vvip-68/GyverLampWiFi/Android/lamp.png

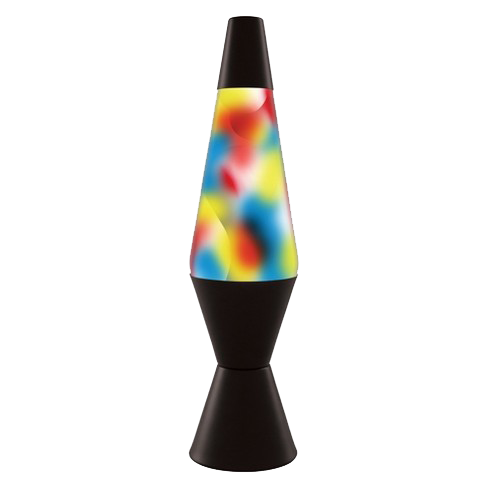
Android/lamp.png
