vvip-68/GyverLampWiFi/Android/menu_bg.png

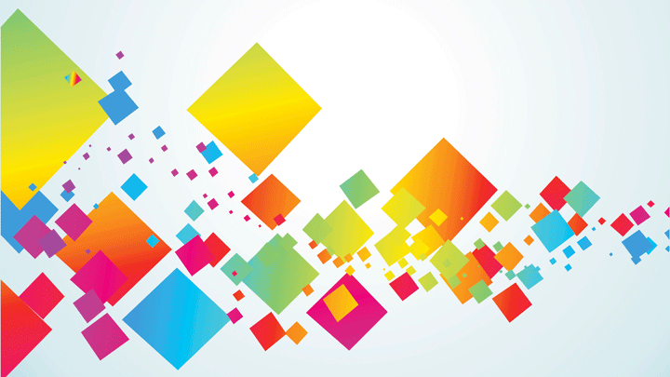
Android/menu_bg.png
