vvip-68/GyverLampWiFi/schemes/nodemcu.png

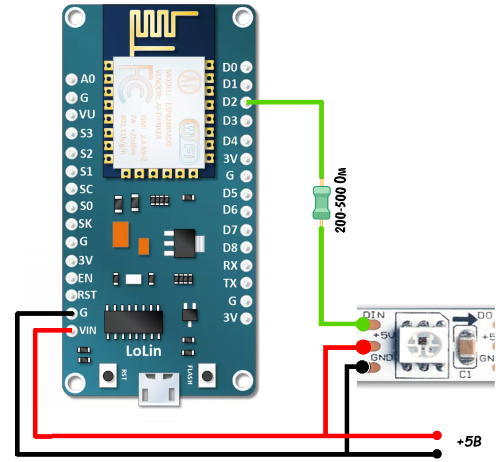
schemes/nodemcu.png
