vvip-68/GyverLampWiFi/schemes/scheme1,1.jpg

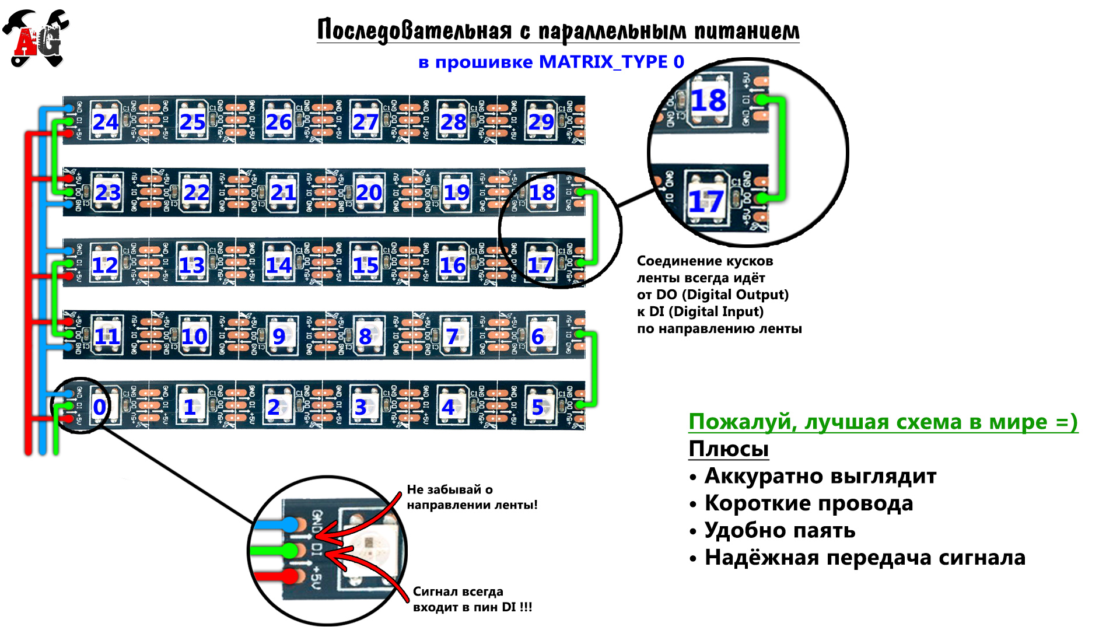
schemes/scheme1,1.jpg
