vvip-68/GyverLampWiFi/schemes/scheme2.jpg

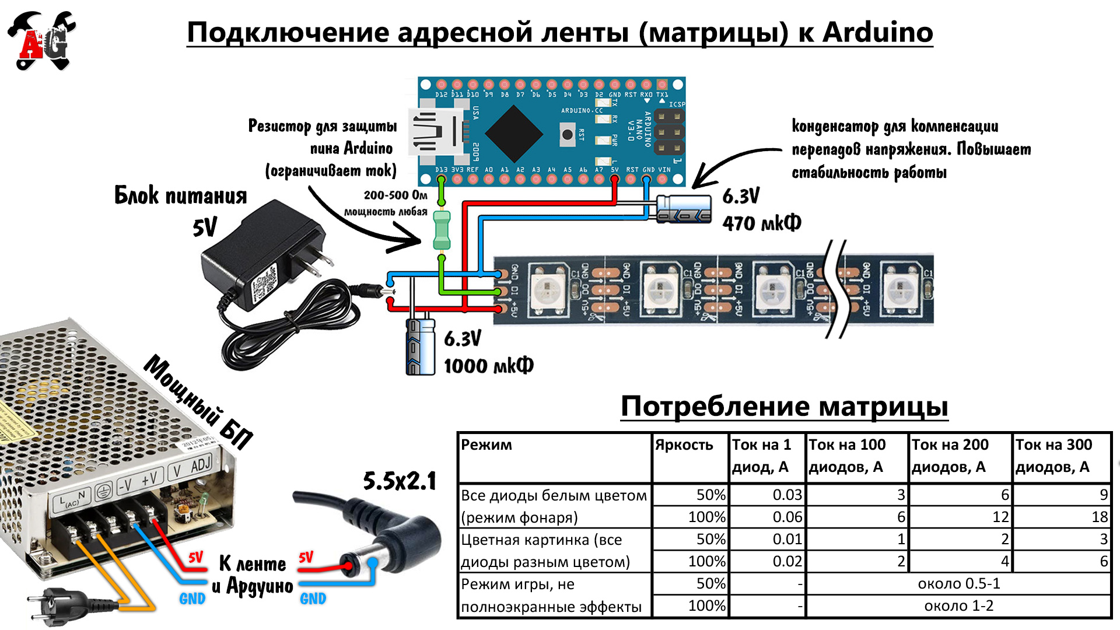
schemes/scheme2.jpg
