vvip-68/GyverLampWiFi/schemes/scheme3.jpg

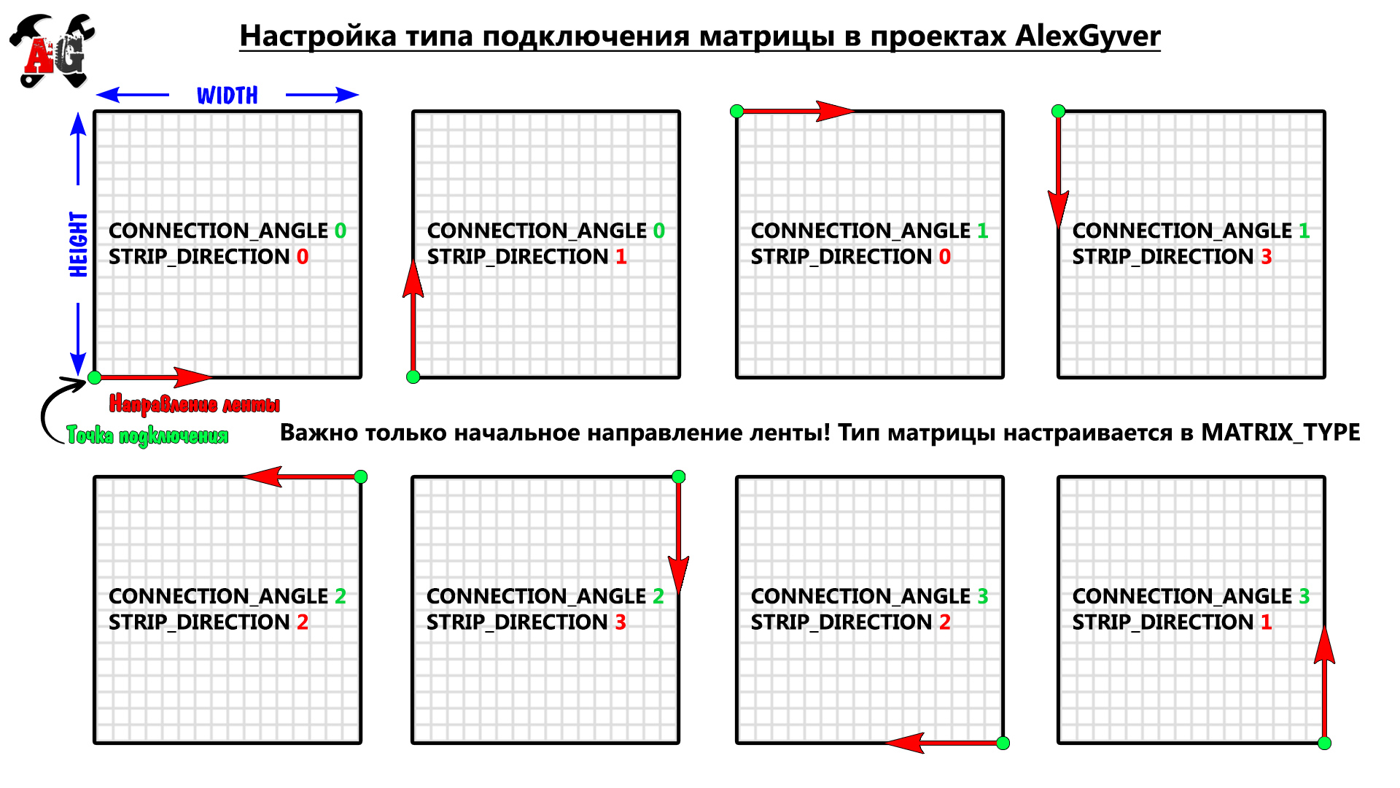
schemes/scheme3.jpg
