vvip-68/GyverLampWiFi/3D_print/STL/ring_for_paper.stl

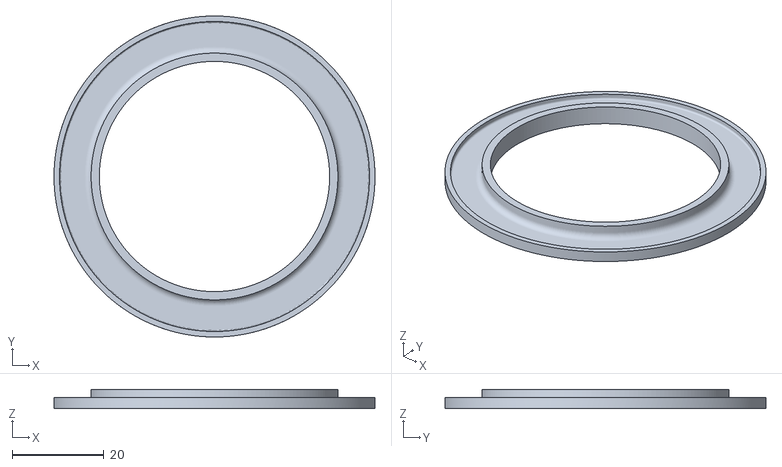
[picture p12: CAD file, 2019-07-05]
3D_print/STL/ring_for_paper.stl
70.0 x 70.0 x 4.20
