vvip-68/GyverLampWiFi/3D_print/STL/Lamp-Top.stl

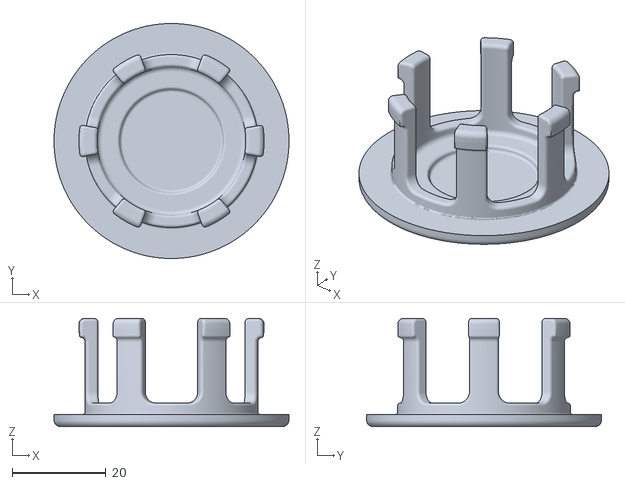
[picture p13: CAD file, 2019-07-05]
3D_print/STL/Lamp-Top.stl
50.0 x 50.0 x 23.0
