vvip-68/GyverLampWiFi/3D_print/STL/Ring_top.stl

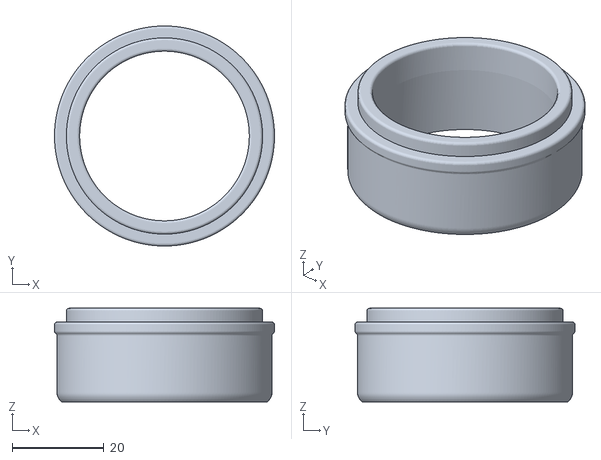
[picture p14: CAD file, 2019-07-05]
3D_print/STL/Ring_top.stl
48.0 x 48.0 x 20.4
