vvip-68/GyverLampWiFi/3D_print/STL/Lamp_Down.stl

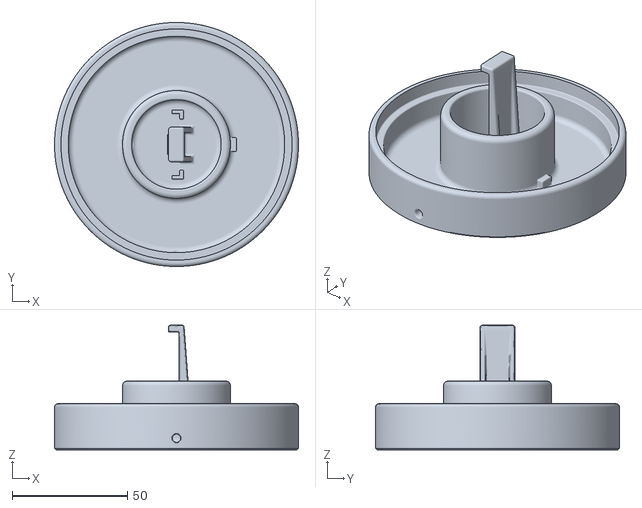
[picture p15: CAD file, 2019-07-05]
3D_print/STL/Lamp_Down.stl
105.8 x 105.8 x 54.0
