vvip-68/GyverLampWiFi/3D_print/STL/Lamp_Down_DC-output.stl

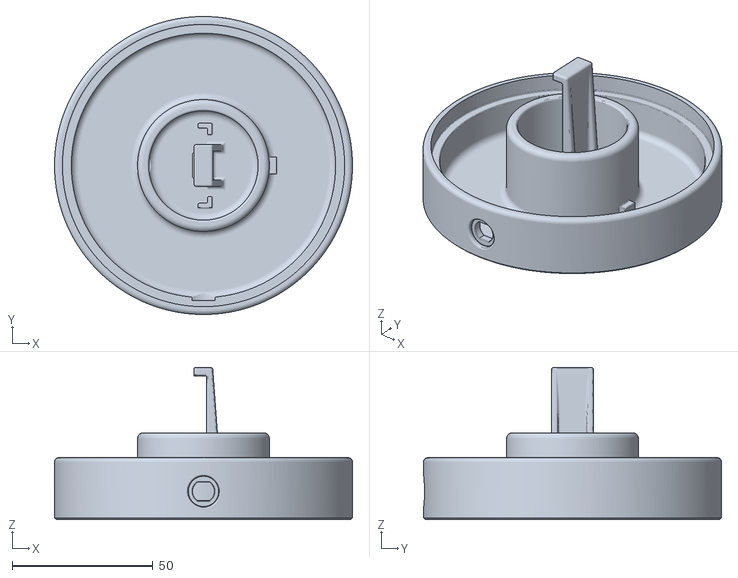
[picture p16: CAD file, 2019-07-05]
3D_print/STL/Lamp_Down_DC-output.stl
105.8 x 105.8 x 54.0
