vvip-68/GyverLampWiFi/3D_print/photo (1).jpg

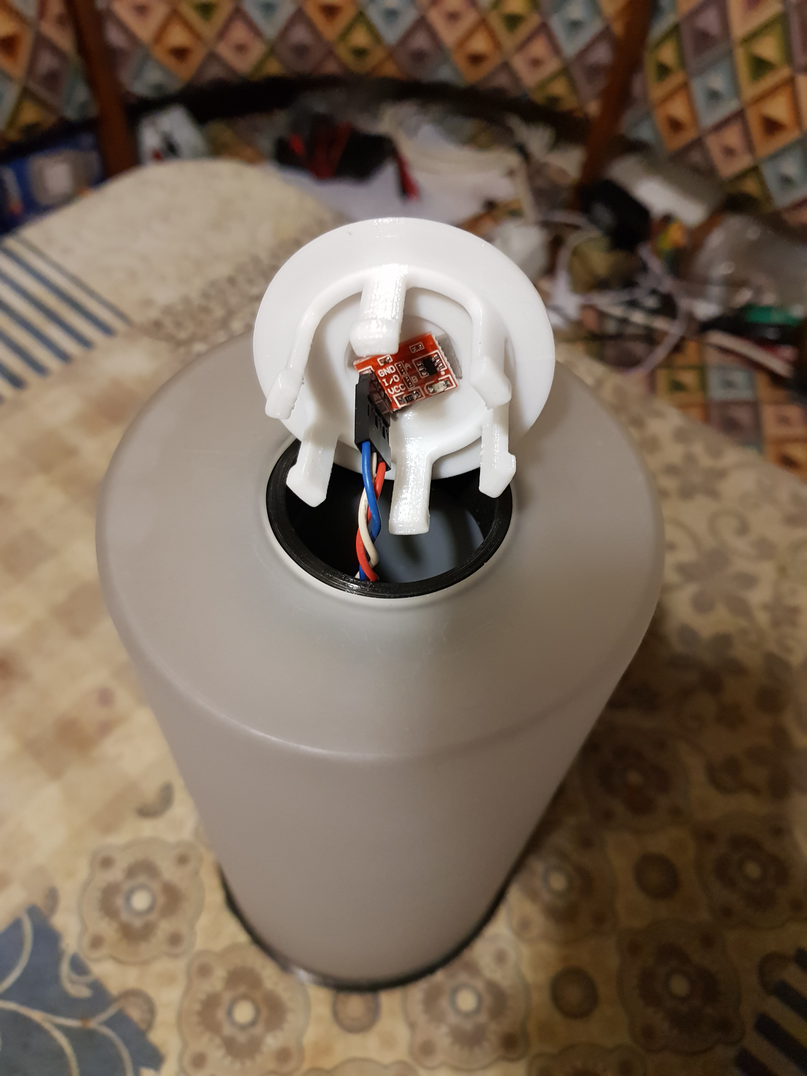
3D_print/photo (1).jpg
