vvip-68/GyverLampWiFi/3D_print/photo (2).jpg

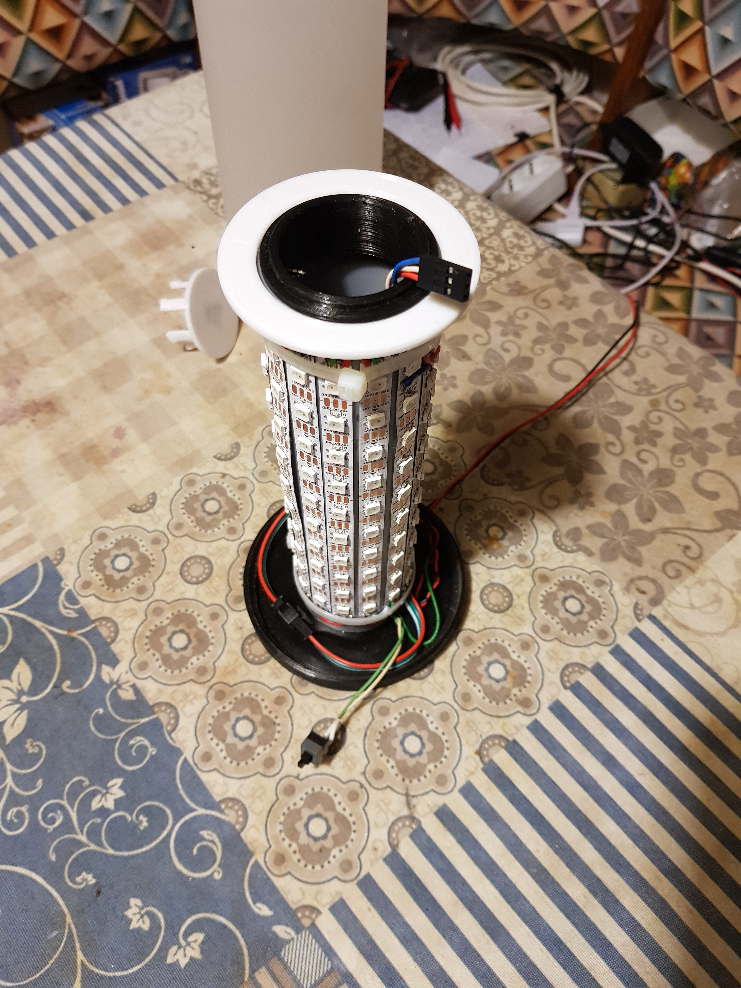
3D_print/photo (2).jpg
