vvip-68/GyverLampWiFi/3D_print/photo (3).jpg

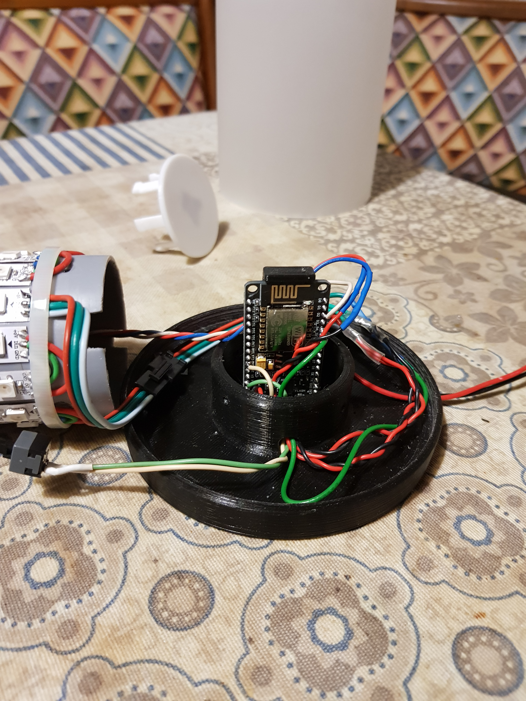
3D_print/photo (3).jpg
