vvip-68/GyverLampWiFi/3D_print/photo (4).jpg

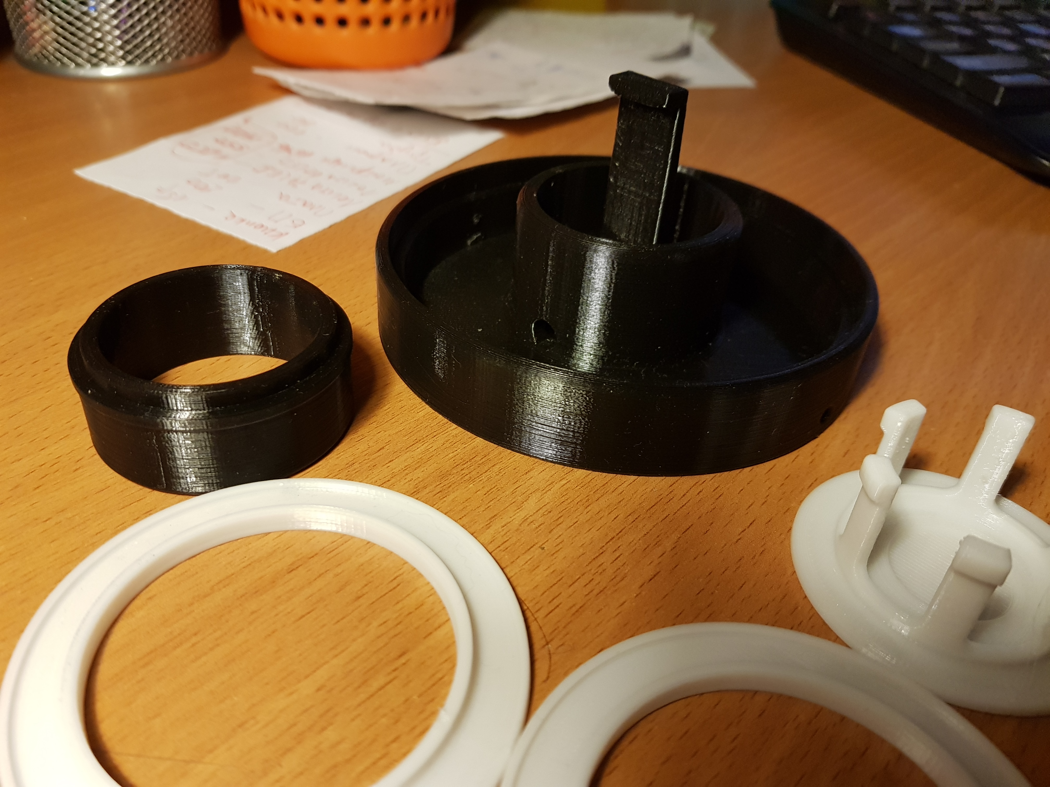
3D_print/photo (4).jpg
