vvip-68/GyverLampWiFi/3D_print/photo (5).jpg

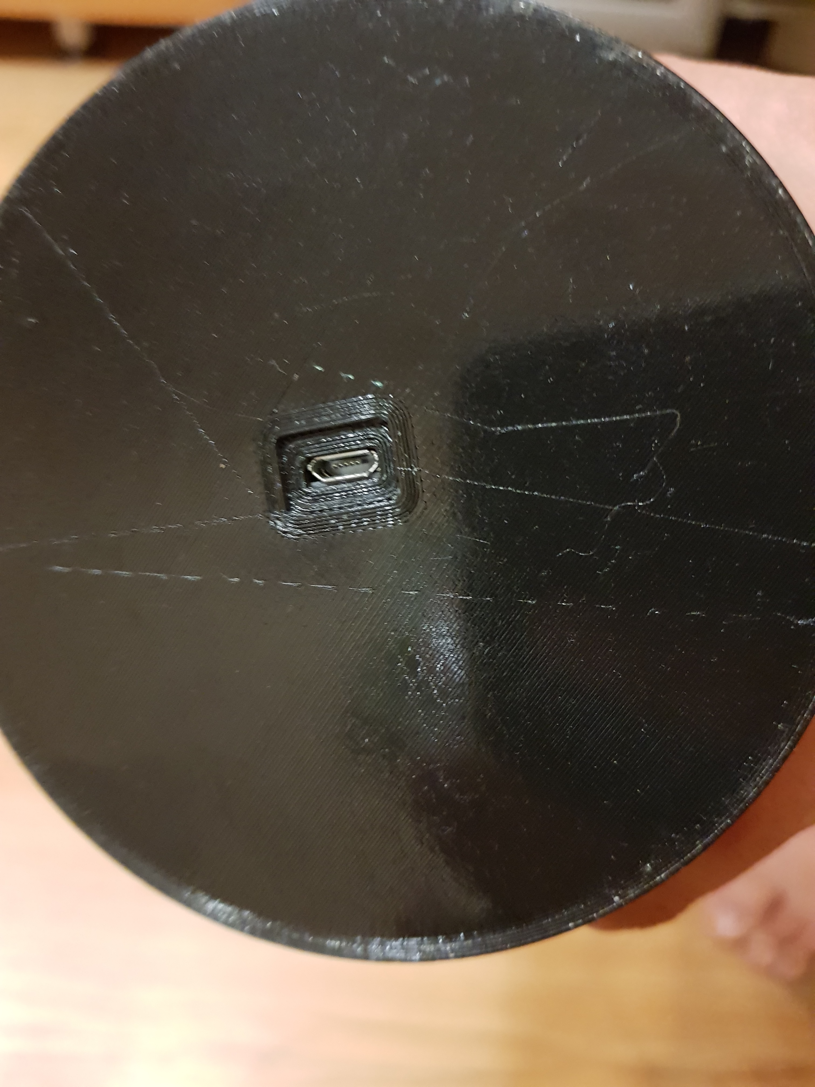
3D_print/photo (5).jpg
