vvip-68/GyverLampWiFi/wiki/Step_01.png

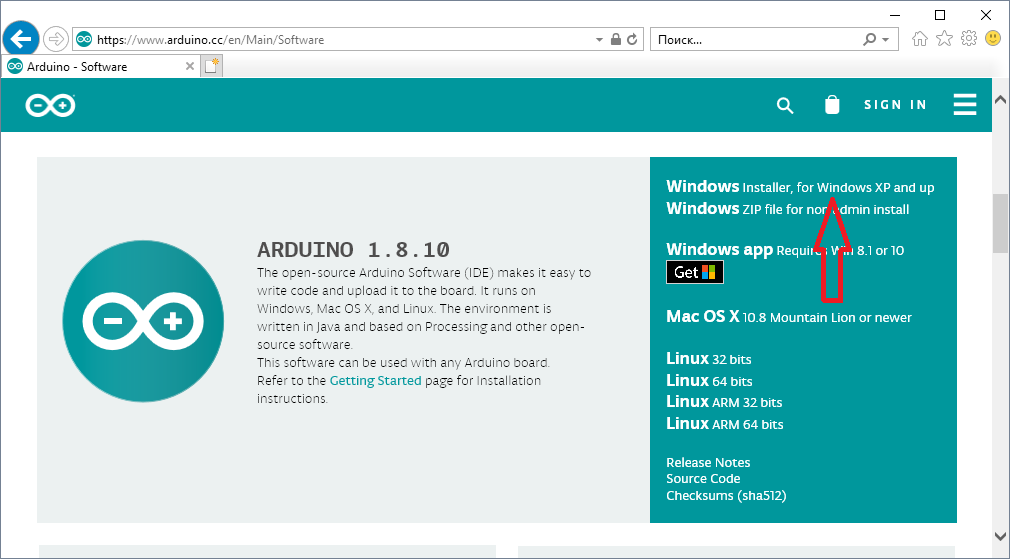
wiki/Step_01.png
