vvip-68/GyverLampWiFi/wiki/Step_02_1.png

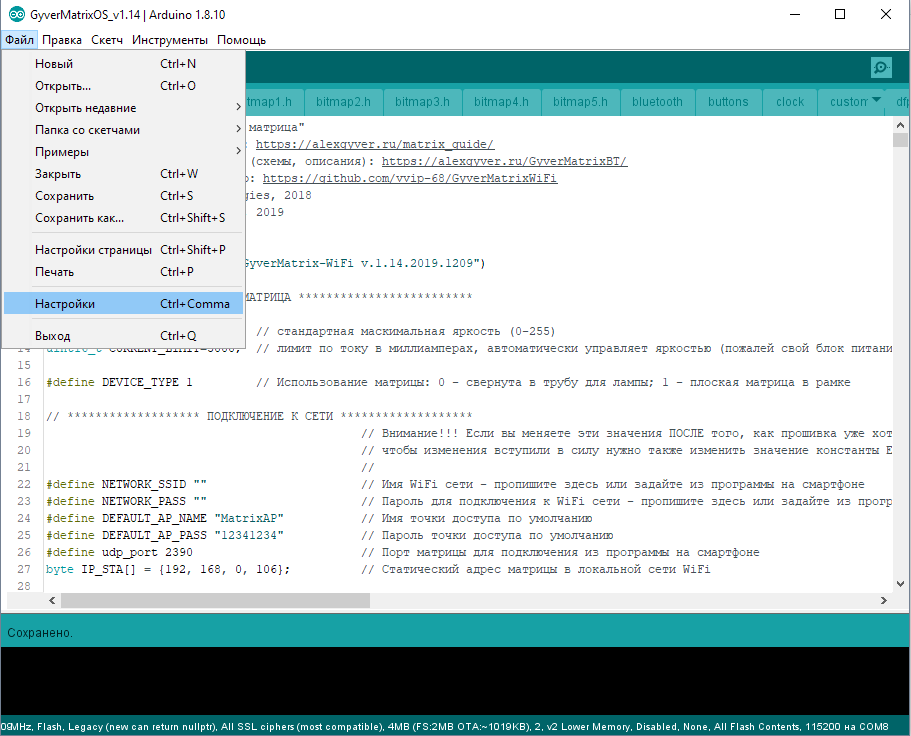
wiki/Step_02_1.png
