vvip-68/GyverLampWiFi/wiki/Step_02_2.png

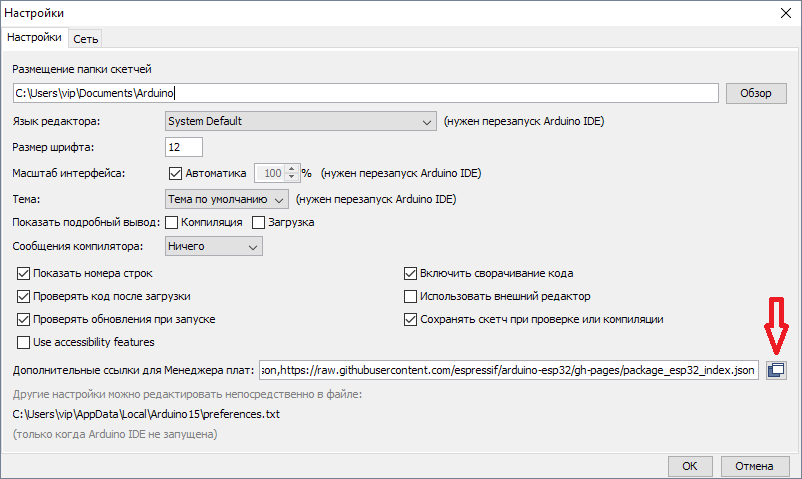
wiki/Step_02_2.png
