vvip-68/GyverLampWiFi/wiki/Step_02_3.png

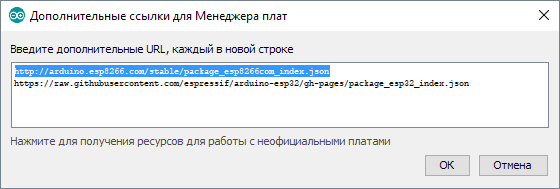
wiki/Step_02_3.png
