vvip-68/GyverLampWiFi/wiki/Step_03_1.png

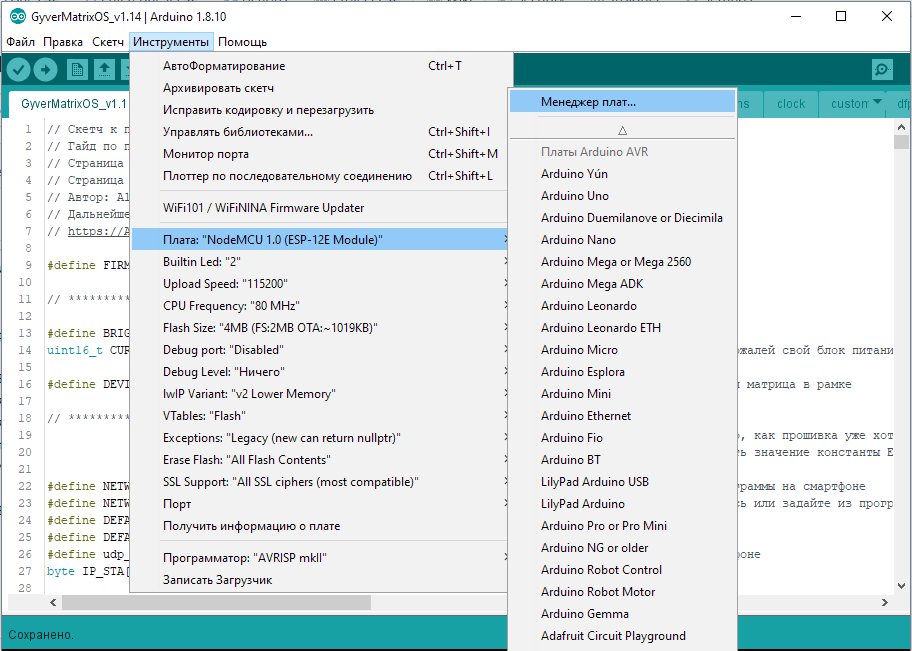
wiki/Step_03_1.png
