vvip-68/GyverLampWiFi/wiki/Step_03_2.png

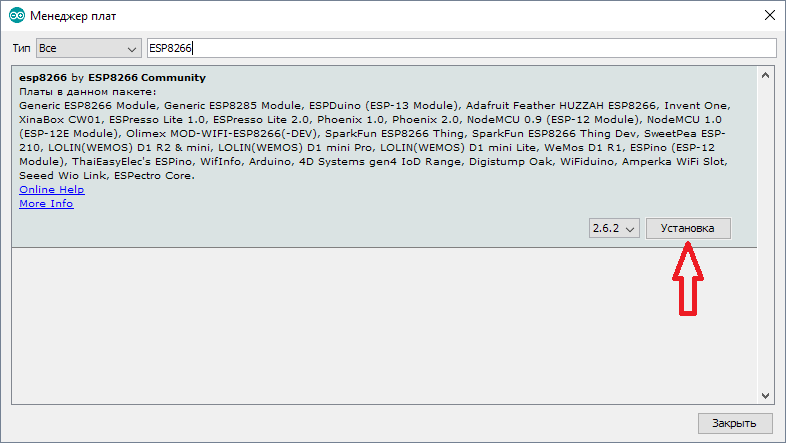
wiki/Step_03_2.png
