vvip-68/GyverLampWiFi/wiki/Step_04_1.png

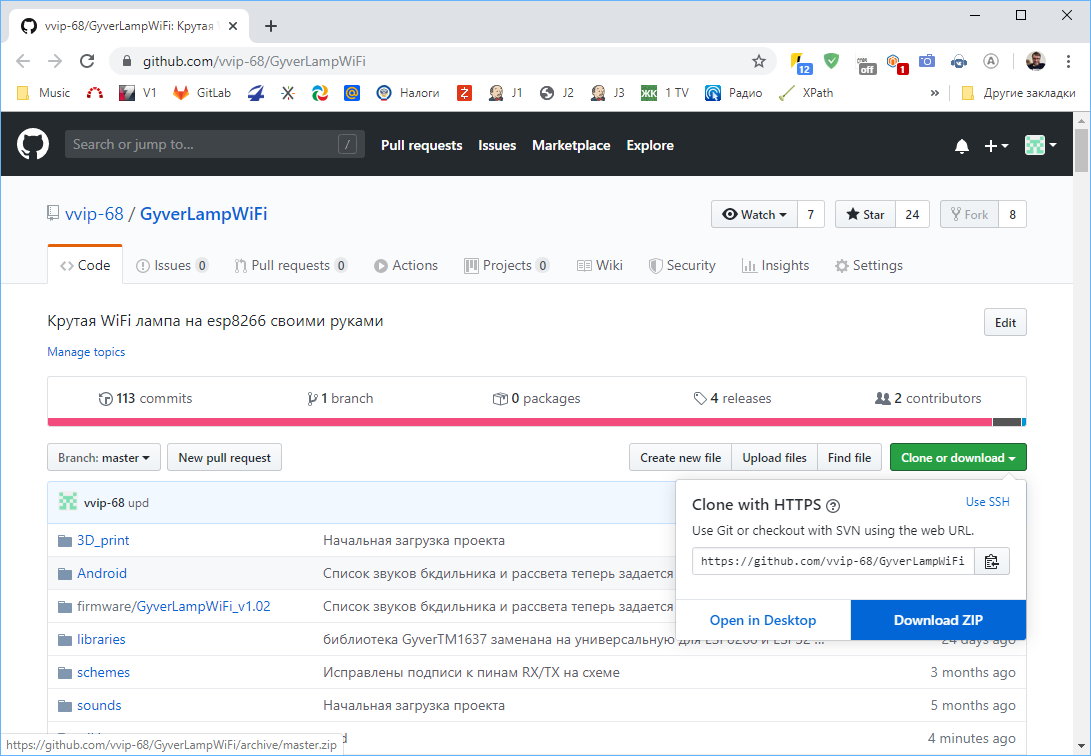
wiki/Step_04_1.png
