vvip-68/GyverLampWiFi/wiki/Step_05_1.png

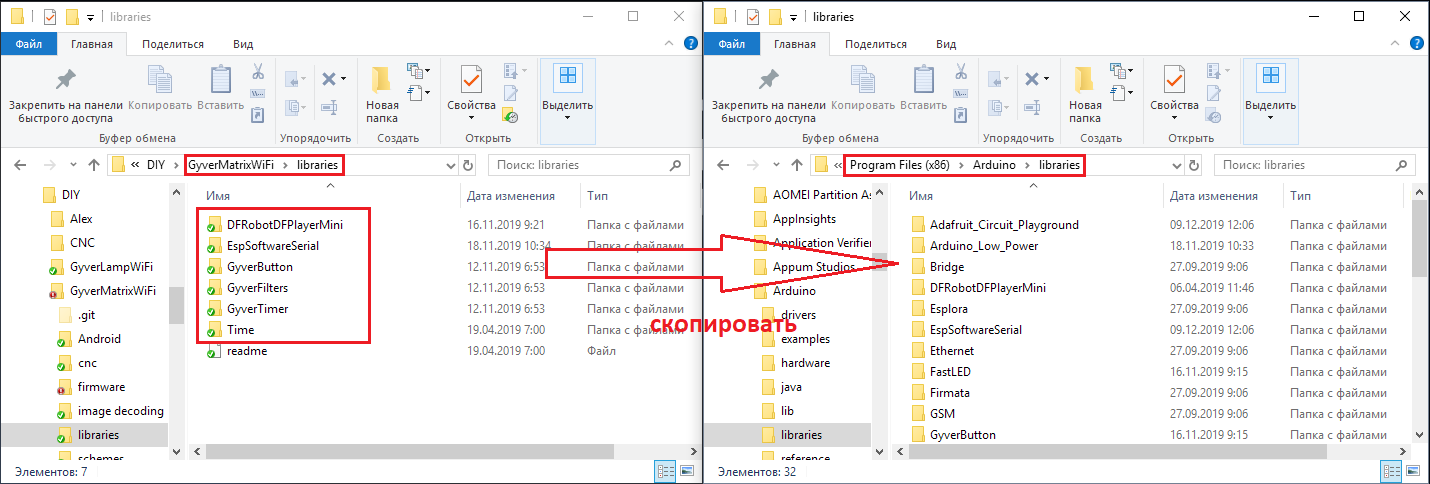
wiki/Step_05_1.png
