vvip-68/GyverLampWiFi/wiki/Step_06_1.png

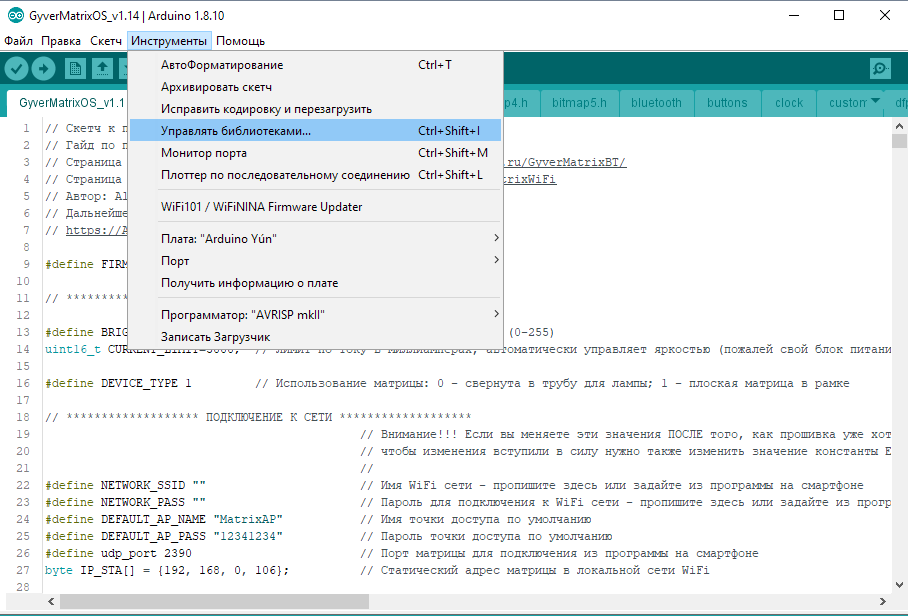
wiki/Step_06_1.png
