vvip-68/GyverLampWiFi/wiki/Step_06_2.png

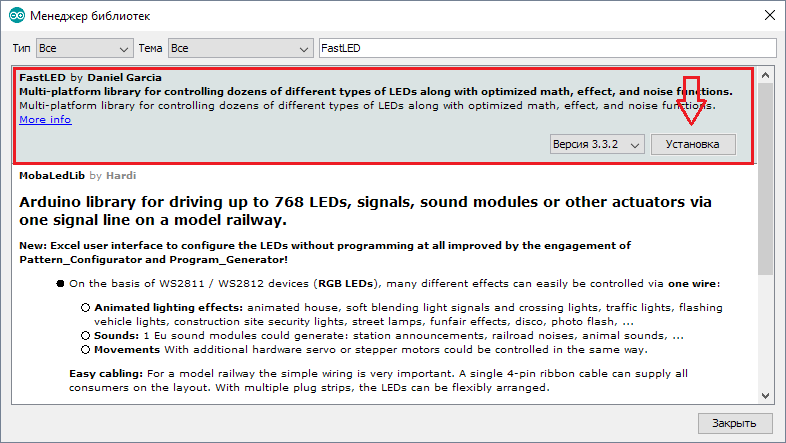
wiki/Step_06_2.png
