vvip-68/GyverLampWiFi/wiki/Step_07_1.png

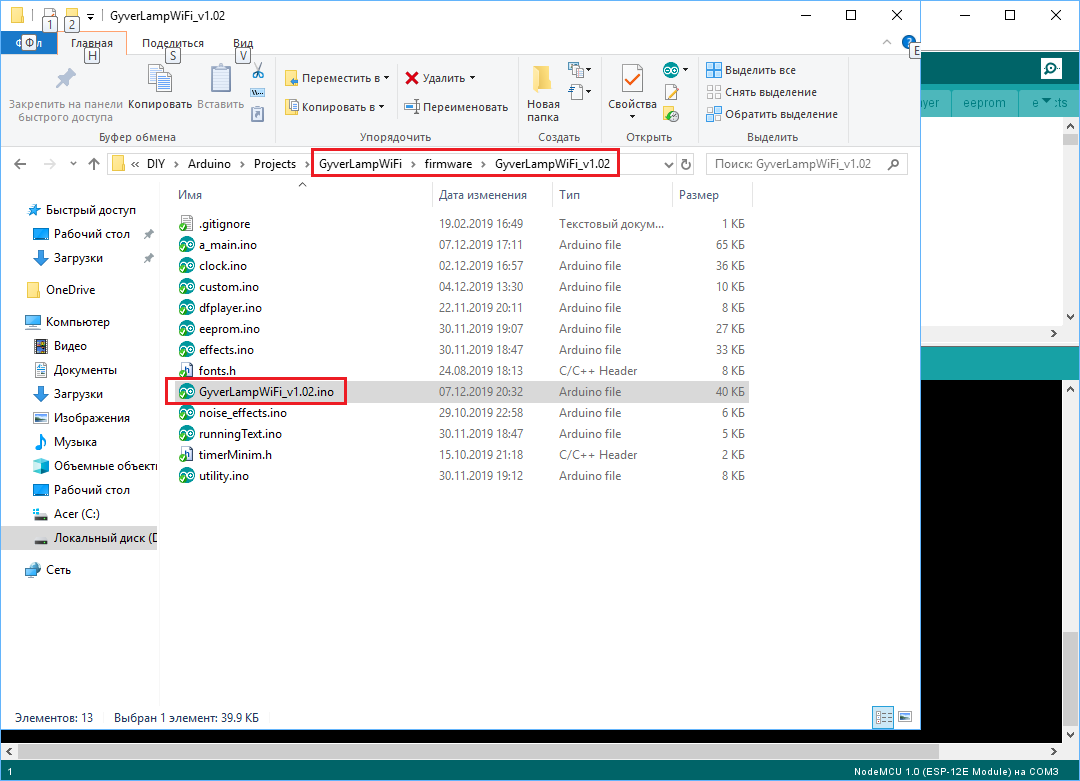
wiki/Step_07_1.png
