vvip-68/GyverLampWiFi/wiki/Step_07_2.png

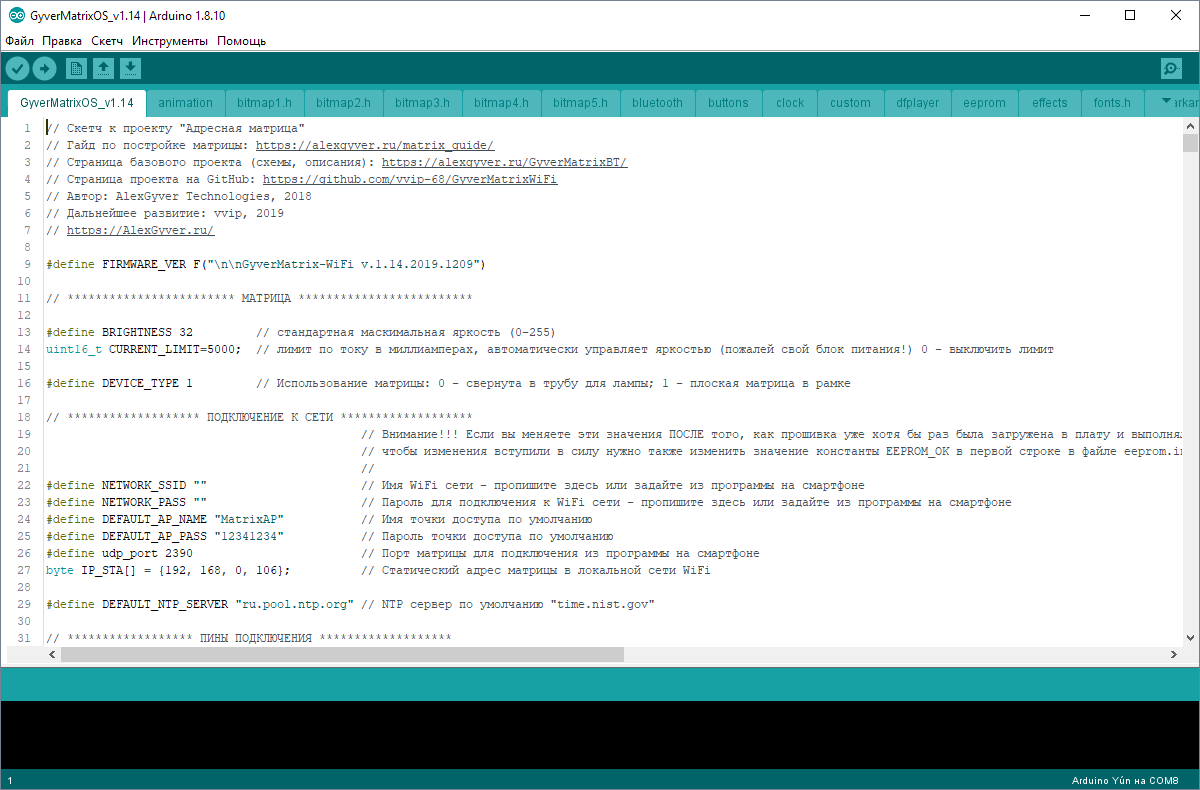
wiki/Step_07_2.png
