vvip-68/GyverLampWiFi/wiki/Step_07_3.png

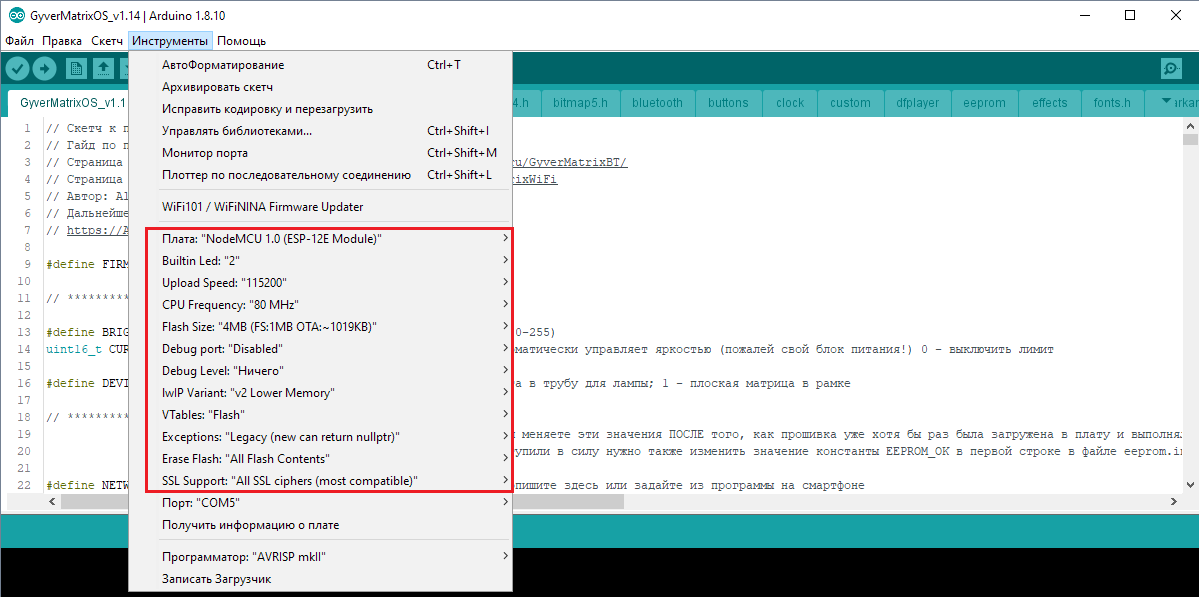
wiki/Step_07_3.png
