vvip-68/GyverLampWiFi/wiki/Step_07_4.png

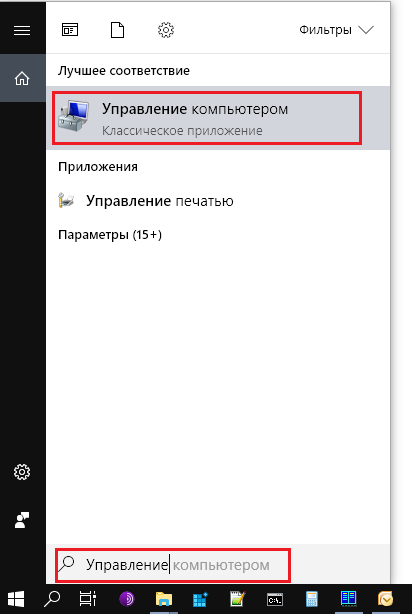
wiki/Step_07_4.png
