vvip-68/GyverLampWiFi/wiki/Step_07_5.png

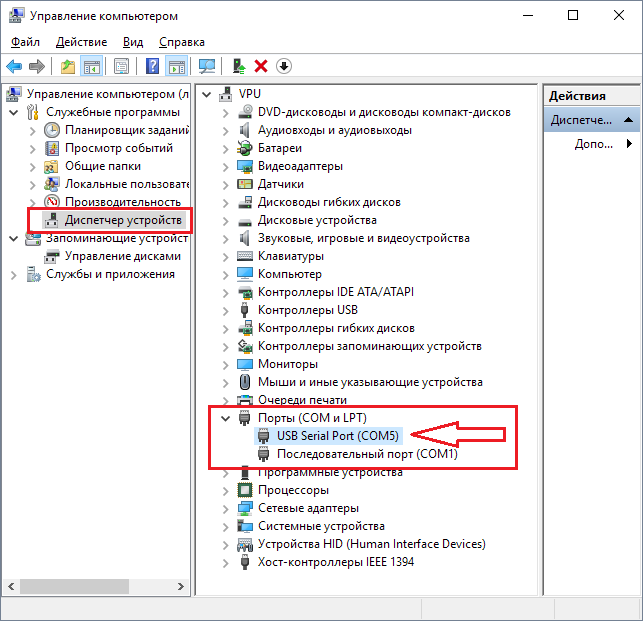
wiki/Step_07_5.png
