vvip-68/GyverLampWiFi/wiki/Step_08_1.png

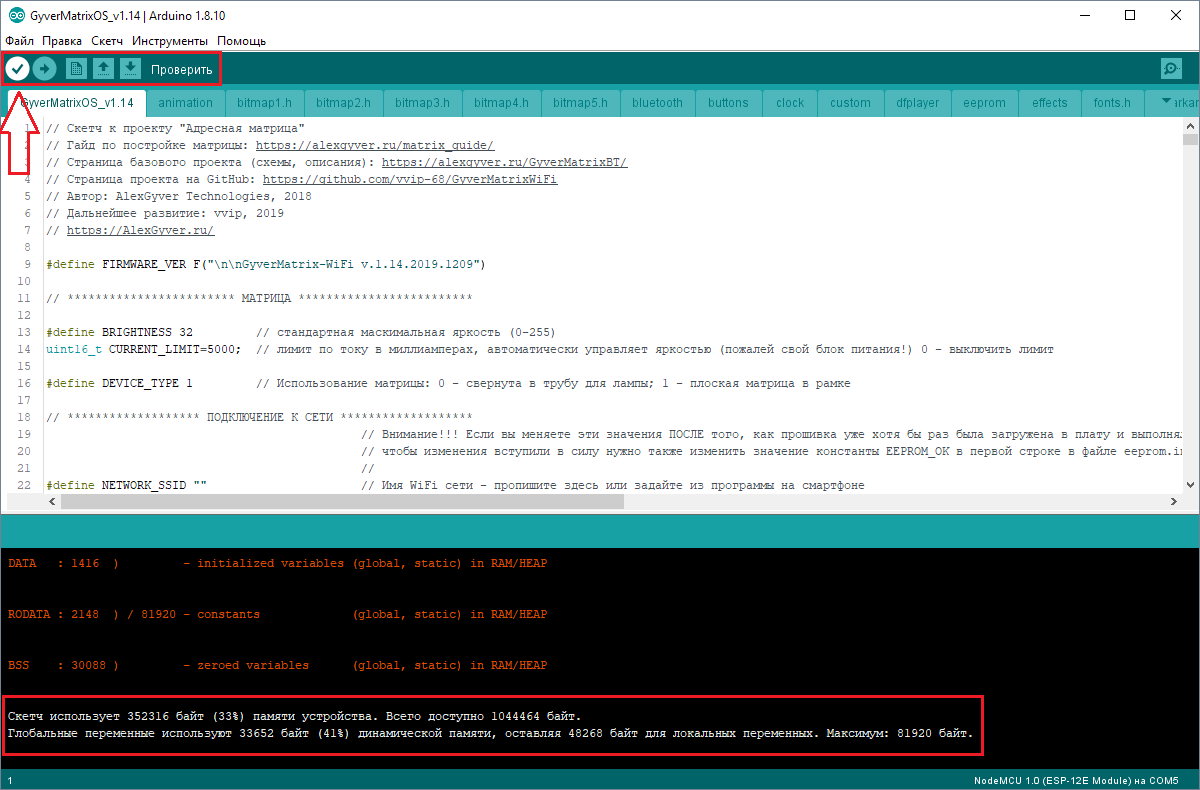
wiki/Step_08_1.png
