vvip-68/GyverLampWiFi/wiki/Step_09_1.png

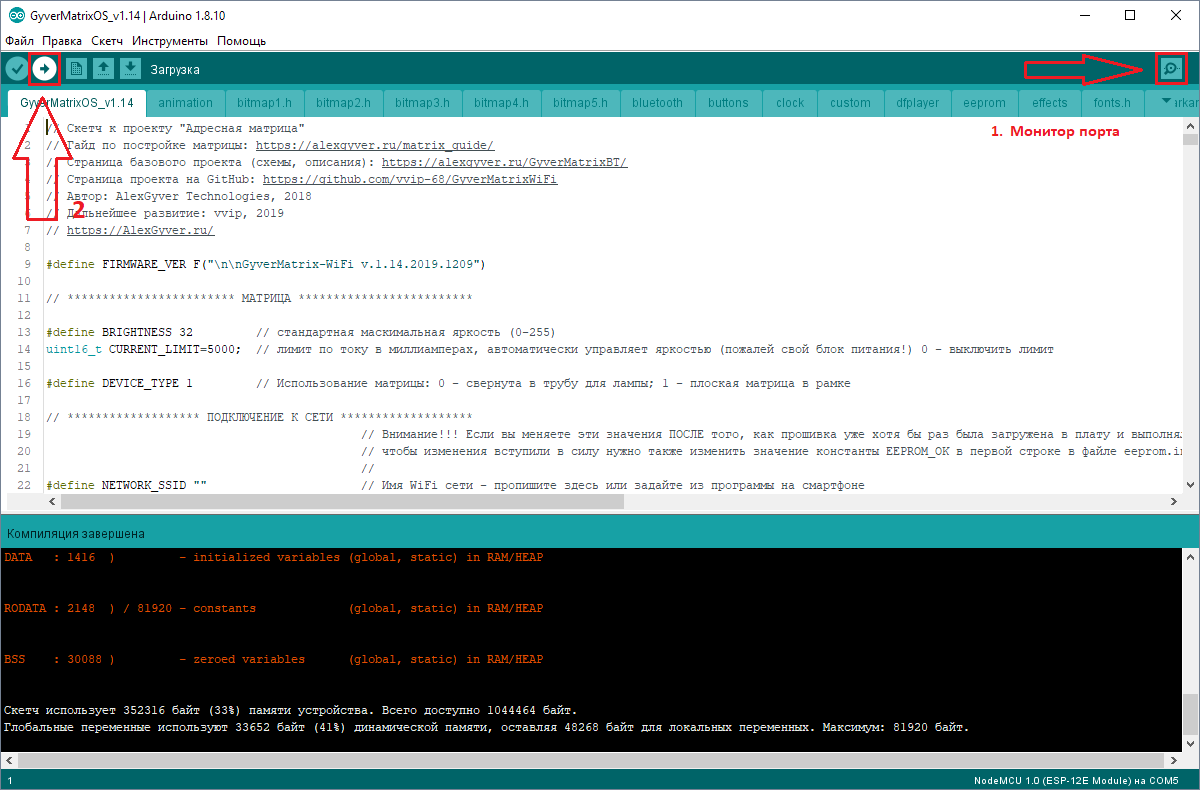
wiki/Step_09_1.png
