vvip-68/GyverLampWiFi/wiki/Step_09_2.png

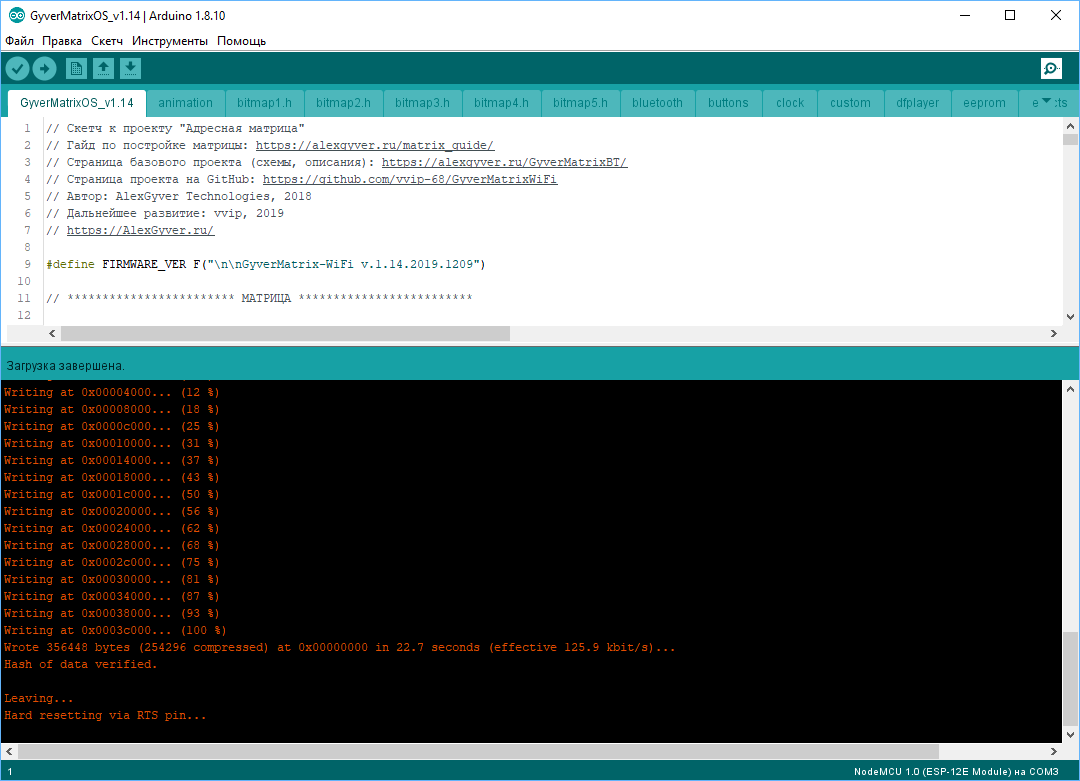
wiki/Step_09_2.png
