vvip-68/GyverLampWiFi/wiki/Step_09_3.png

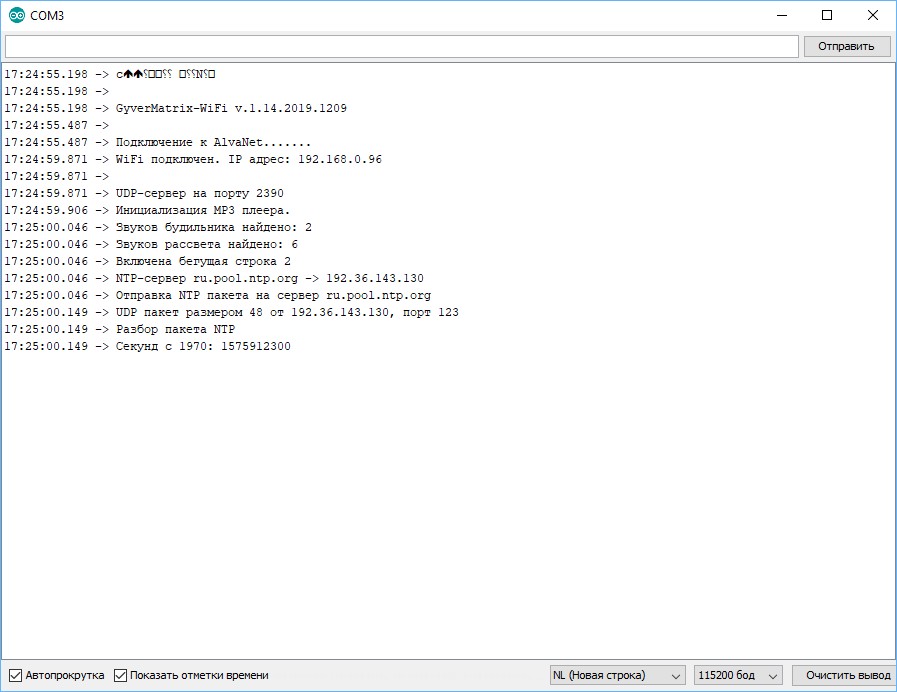
wiki/Step_09_3.png
