vvip-68/GyverLampWiFi/(threads)

Thread 1 (2019-07-20):

приложение android

olegkyka, 2019-07-20:
Приветствую. Я так понял, что в приложении эффекты выбираются рандомно? Или я чего то  туплю.

vvip-68, 2019-07-25:
Нет. В приложении эффекты выбираются из списка (комбобокс), а если включен режим демонстрации (автосмена) - по кругу как это определено в прошивке.

Closed 2019-07-25.

Thread 2 (2019-08-26):

MP3 плеер

dipcore, 2019-08-26:
Можно ли добавить функционал mp3 плеера с флеш карты. Хорошая бы лампа с музыкой в детскую получилась бы.

AndyIP70, 2019-08-27:
Доброго времени суток vvip-68!
Подскажите пожалуйста, данный проект (GyverLampWiFi
) основан на версии 1.4 от AlexGyver?
Если нет - не могли бы вы синхронизировать этот проект с версией 1.4

vvip-68, 2019-09-01:
Хм.. Я галочку себе поставлю, но вопрос сроков реализации и вообще буду ли я это делать - даже не знаю. Это ж кроме проигрывания нужно как-то интерфейсно (в приложении например) реализовывать управление - что играть, как играть, всякий доп. функционал. Какие-то кнопки... Но, в принципе, идея интересная, достойна обдумывания...

BaLD-91, 2019-09-16:
Поддерживаю идею! Раз уже есть плеер и динамик, было бы классно релаксировать, глядя на лампу, под треск огня, пение птичек, шум леса и т.д.

vvip-68, 2019-09-27:
Ну так то это и сейчас возможно - именно перечисленные звуки есть на карточке, включить их можно на вкладке "Будильник" в приложении - там комбобокс выбора звука рассвета и кнопка "Пуск" чтобы начать воспроизведение.  Файлы достаточно длинные, на несколько минут, к тому же, кажется, воспроизведение зациклено.

Closed 2019-09-27.

Thread 3 (2019-08-27):

ver 1.4 or not?

AndyIP70, 2019-08-27:
Доброго времени суток vvip-68!
Подскажите пожалуйста, данный проект (GyverLampWiFi
) основан на версии 1.4 от AlexGyver?
Если нет - не могли бы вы синхронизировать этот проект с версией 1.4

vvip-68, 2019-09-01:
Нет, не на версии 1.4 от Гайвера. Ничего общего. Функционал - тот же самый, внутри код другой. Что значит синхронизировать?

AndyIP70, 2019-09-02:
Прошу прощения. Я имел в виду синхронизировать с версией 1.4 если ваш код основан на коде от AlexGyver версии 1.3 к примеру.
На так как это ваш собственный код - просьба не имеет смысла :)
И кстати спасибо за последние фиксы кода. Стабильность - это всегда хорошо!

k0cm0c, 2019-09-02:
> ESP8266 - ведет себя очень не стабильно, часто перезагружается не смотря на все усилия:
> стабилизировал питание +5v, переводил схему на +3v - один фиг. Ребуты самы разные. Может проработать 10 минут, а может и 2 часа. :(

у меня на руках 2 штуки  esp8266mod ai-thinker он же ESP-12F один работает стабильно. у другого глюки через раз. Ни с питанием, ни с прошивкой, какой либо закономерности нет, возможно стоит поменять на другой

vvip-68, 2019-09-04:
Я ставил эксперименты. Заливал разные прошивки и запускал на сутки (или до первого вылета) с монитором порта. Прошивки эти - GyverMatrixBT, GyverLamp 1.4, dот эта лампа GyverLampWiFi b GyverMatrixWiFi 1.13. Вылетают ВСЕ. Могут проработать почти сутки без сбоев, могут 3 раза за час перегрузиться. Зависит, видимо, от фазы луны. Даже убирал все из прошивки и в loop() оставлял только вызов эффекта "Матрица". Вылетает и в таком варианте.
Однако, взял пустую прошивку, добавил туда UDP и чтение (прослушивание) и один из примеров от FastLED. Такой вариант проработал трое суток без вылетов. Так что - ХЗ почему вылетает. Или нестабильность ядра ESPшки или проблемы в библиотеке FastLED.
У FastLED вышло обновление до 3.2.2 - поставил его. Прошло 12 часов - пока не вылетало. Подождем еще пару суток. Или они поправили что-нибудь у себя, или попробуем переписать код для использования AdaFruit вместо FastLED

vvip-68, 2019-09-04:
>И еще вопрос - планируется ли портирование для платы esp32?
Не планировал. У меня и платы то такой нет. Насколько я знаю она [значительно] дороже ESP8266 и значительно мощнее. Применение ее тут - что из пушки по воробьям.
А что, напрямую без переделок, если прошивку в нее залить - не собирается?

k0cm0c, 2019-09-04:
> У FastLED вышло обновление до 3.2.2 - поставил его.
Тоже обновил, 3.3.2 поставлю на прогон )

vvip-68, 2019-09-04:
Вылетает все равно. Придется, видимо, на AdaFruit переписывать

AndyIP70, 2019-09-11:
Нез наю как именно, но последний релиз очень стабилен :)

Closed 2019-09-11.

Thread 4 (2019-09-01):

продолжает работать в режиме AP_STA после получения статического адреса

k0cm0c, 2019-09-01:
https://github.com/vvip-68/GyverLampWiFi/blob/7b39d409c11533ff9d039b51cb9a21bcccb5e53c/firmware/GyverLampWiFi_v1.00/GyverLampWiFi_v1.00.ino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

WiFi.mode(WIFI_AP_STA);  заменить на WiFi.mode(WIFI_STA);

vvip-68, 2019-09-01:
Да, спасибо. Исправил.

Closed 2019-09-01.

Thread 5 (2019-09-01):

При получении динамического адреса от роутера, остаётся статический

k0cm0c, 2019-09-01:
https://github.com/vvip-68/GyverLampWiFi/blob/7b39d409c11533ff9d039b51cb9a21bcccb5e53c/firmware/GyverLampWiFi_v1.00/GyverLampWiFi_v1.00.ino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

byte IP_STA[] = {192, 168, 0, 116};  заменить на  byte IP_STA[] = {0, 0, 0, 0};

vvip-68, 2019-09-01:
Это сделано специально для начального после прошивки получения указанного статического адреса. При первой загрузке. Далее этот адрес берется из EEPROM при каждом запуске прошивки. В приложении есть настройка - статический адрес. Если туда вбить 0.0.0.0 - он сохранится в EEPROM и при следующих загрузках будет получаться динамический адрес.

k0cm0c, 2019-09-01:
Так и предполагал, но у всех разные подсети на роутерах, например - у меня 10.0.0.0/24, при первом включении после прошивки создается LampAP, настраивается сеть, пароль, а в поле статического адреса - "нет подключения"  далее, по логике обывателя - кнопка сохранить, и после перезагрузки подключается к роутеру, но с статическим IP 192.168.0.116 вместо какого либо из моей подсети. соответственно, к лампе не подключиться.

Closed 2019-09-01.

Thread 6 (2019-09-10):

Time 00:00

AndyIP70, 2019-09-10:
Доброго времени суток.
Залил прошивку. Все настроил. Работает просто замечательно и стабильно.
Но! Когда время на часиках 00:00 (полночь), программа входит в бесконечный цикл
и пишет с обалденной скоростью в монитор порта тукую строчку:
00:01:22.460 -> Включен эффект 'Лампа,Снегопад,Шарик,Радуга вертикальная,Огонь,The Matrix,Шарики,Звездопад,Конфетти,Радуга диагональная,Цветной шум,Облака,Лава,Плазма,Радужные переливы,Полосатые переливы,Зебра,Шумящий лес,Морской прибой,Смена цвета,Радуга горизонтальная,Светлячки,Рассвет'
Посмотрите плизз где загвоздка...

Thread 7 (2019-09-12):

Две лампы

ermiyaev, 2019-09-12:
Как насчёт возможности одновременного управления/синхронной работы двух и более ламп? (Не так, чтобы прям пиксель в пиксель совпадали, а режим и яркость)
Либо в приложение добавить возможность вносить более одного ip адреса ламп. Либо, возможно, ещё лучше дать второй лампе возможность брать информацию о состоянии и режиме работы с основной лампы

vvip-68, 2019-09-27:
Ну это требует серьезной переработки кода... Не думаю, что у меня в ближайшем будущем найдется время но это, но чем черт не шутит, возможно когда-нибудь...

Closed 2019-09-27.

Thread 8 (2019-09-16):

Длина пароля WiFi

inrovert, 2019-09-16:
Доброго времени суток. Может быть я ошибаюсь, но мне показалось, что нашел несоответствие между длиной строковых переменных: строки 195, 196 в файле GyverLampWiFi_v1.00.ino и строки 112, 113 в файле eeprom.ino. Размеры перепутаны местами. Огромное спасибо за проделанную работу! Семья в восторге :-)

inrovert, 2019-09-26:
Доброго времени суток. Может быть я ошибаюсь, но мне показалось, что нашел несоответствие между длиной строковых переменных: строки 195, 196 в файле GyverLampWiFi_v1.00.ino и строки 112, 113 в файле eeprom.ino. Размеры перепутаны местами. Огромное спасибо за проделанную работу! Семья в восторге :-)

vvip-68, 2019-09-27:
Хм.. Ну, судя по описанию
  //  54-63   - имя точки доступа    - 10 байт
  //  64-79   - пароль точки доступа - 16 байт
именно в строках 112,113 указано правильно - такая длина и есть.
А вот в объявлении в основном файле строки 208,209
char apName[17] = "";                    // Имя сети в режиме точки доступа
char apPass[9]  = "";                    // Пароль подключения к точке доступа
таки получается да - перепутано, надо поменять местами.
Считаю имени точки доступа в 10 символов вполне достаточно. Это то как вы называете свою лампу, если у вас их несколько - "Lamp1", "Lamp2" например и все они работают в режиме точек доступа без подключения к сети
R  ому же в файле a_main.ino строки 397-407 где происходит получение этих параметров от приложения тоже прописано 10 на имя и 17 на пароль.

Closed 2019-09-27.

Thread 9 (2019-09-30):

Power on TM1637

AndyIP70, 2019-09-30:
Добрый день!
Лампа работает шикарно! Спасибо большое за прошивку!
Есть одно замечание. Может быть кому нибудь поможет.
Пришли из китая индикаторы TM1637. Брал тут:
https://ru.aliexpress.com/item/32845754229.html?spm=a2g0s.9042311.0.0.274233edIYNiAl
Ну так вот, на индикаторе написано, что он питается от 5 вольт.
Мой блок выдает 5.1 вольта. И индикатор уходит в защиту.
Оказалось, что индикатор хочет 3.3 вольта :) и замечательно работает!
И соответственно, запитывать его нужно непосредственно от выхода 3.3v на esp8266
Может быть стоит добавить это в FAQ в READ.ME?

vvip-68, 2019-10-01:
Хм... На картинке индикатора написано вход питания 5V.
Ни разу не встречал TM1637, которые требовали бы 3.3 вольта. Все с чем сталкивался нормально работали от 5В. А вывод с выхода 3.3 В нормально тянет? Там ток допустимый, вроде, небольшой...

AndyIP70, 2019-10-01:
Да. Тянет нормально.

Closed 2019-10-01.

Thread 10 (2019-10-14):

ESP32

AndyIP70, 2019-10-14:
Добрый вечер!
У меня просьба, создайте пожалуйста порт данной прошивки для платформы ESP32 (ESP32 Dev Module).
Я сам пробовал, кроме кучи ошибок ничего не добился :(

vvip-68, 2019-10-15:
Ну так спрашивал бы где на форуме, в обсуждениях что за ошибки, как их устранять.
Я про ESP32 ничего не знаю и как его вообще в Arduino IDE прикручивать тоже. И в наличии у меня его нет. Портируешь - пиши. А почему тебе именно ЭТОТ вариант лампы нужен?
Вон у Гуннера уже давно под ESP32 портировали. Там и возможностей много больше.
https://community.alexgyver.ru/threads/wifi-lampa-budilnik-obsuzhdenie-proekta.1411/page-52#post-14055

AndyIP70, 2019-10-15:
Мне нравится вариант с часами и музыкой :) Да сама реализация кажется более удобной.
Вообщем мне все удалось портировать, за исключением одного момента.
В файле clock.ino есть такая строка:
if (!timeServerIP.isSet()) timeServerIP.fromString(F("192.36.143.130"));
при использовании ESP32 подключается другая библиотека методов TCP/IP UDP
и данного метода (.isSet) там просто нет.
Я заменил эту строку следующим кодом:
String ip = "";
  if (!timeServerIP.fromString(ip)) timeServerIP.fromString(F("192.36.143.130"));
вроде прокатило, прошивка компилится без проблем.
Но, я не уверен что данный код работает правильно... :)
Ну и собственно если код работает не правильно - хотел бы получить совет как обойти это препятствие.

vvip-68, 2019-10-15:
Ну так то вроде все верно - if (!timeServerIP.fromString(ip)) по документации возвращает false, если не удалось из строки получить валидный IP адрес. Должно работать.

AndyIP70, 2019-10-15:
Спасибо!

Closed 2019-10-15.

Thread 15 (2019-12-17):

Android app

udavst, 2019-12-17:
Почему-то приложение не запускается, белый экран и вылетает. Mate20, Android 9, права даны.

vvip-68, 2019-12-17:
Попробуйте переустановить приложение. Возможно у вас недостаточно свободной памяти- освободите ее. Если есть аккаунт в Thunkable Classic - загрузите исходник приложения (aia-файл) в конструктор и соберите приложение оттуда, затем загрузите его в телефон.

udavst, 2019-12-17:
Переустанавливал, памяти полно, ~300 других приложений горя не знают. Зарегился в Thunkable, загрузил проект, нажал сохранить apk - не устанавливается, ошибка пакета. Более глубоко с Thunkable, видимо, я разберусь не скоро (
Оригинальная GyverLamp и GyverLamp от AK47 работают.

vvip-68, 2019-12-17:
Ну если вы таки в Thunkable - у вас есть аккаунт в Classic. Это отлично.
apk надо собирать в 26-ой версии API
В 28-ой не соберется. Thunkable не переваривает таких больших программ в 28 API

udavst, 2019-12-17:
Видимо не судьба( я на thunkable.com загружаю GyverLampWiFi.aia, показывает, что загружен, но ничего на экране не меняется, тест на телефоне показывает тот же белый экран, меню выбора апи я вообще не нашёл, есть только скачать апк, и тестировать  на телефоне, странный сайт, никаких инструментов.

vvip-68, 2019-12-17:
Может у вас с компом что-то не так? Вот только сегодня утром приложение правил - разметку, чтобы на узких телефонах кнопка не "уплывала"...

udavst, 2019-12-17:
Я понял, я файл в проект импортирую, а надо как готовый проект, но нет на сайте этих кнопок, пробовал уже в разных браузерах (
[http://bel.ddns.info/index.php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](url)

vvip-68, 2019-12-17:
https://drive.google.com/file/d/1tAyQd0gGyJiIeBybreIidRstMf7WMr0M/view?usp=sharing

udavst, 2019-12-17:
Ну ладно, обойдусь значит. Меня на сайт на скриншоте не пускает, перекидывает на новый сайт https://x.thunkable.com - а там нет импорта.

vvip-68, 2019-12-17:
Ну да, Classic закрыт для подключения новых пользователей. Проект из Classic в Иксы загрузить невозможно - там совсем другая инфраструктура. В иксах можно только заново с нуля проект создавать. Но он очень кастрированный, многих нужных расширений в иксах просто нет. Не видел еще ни одного реального проекта созданного в иксах - так, баловство, тесты, упражнения простейшие.

Closed 2019-12-17.

Thread 16 (2019-12-19):

Приложение для андроида

Militar49, 2019-12-19:
На 9 андроид приложение не работает... Вылетает при запуске, помогите решить проблемму

vvip-68, 2019-12-20:
На андроид 9 приложение работает. У самого телефон с 9-ым андроидом.
То что не работает конкретно на вашем телефоне... Проблема скорее всего именно в вашем телефоне.
Не знаю. Ничем помочь не могу. Приложение собрано в конструкторе Thunkable Classic - вот как он собирает, такое и приложение получается. И ничего с этим поделать нельзя. Это не управляется.

Militar49, 2019-12-20:
Проверял на 2 телефонах хонор 20 и хонор 10 вылетает при запуске, на сони
эхспирия с 7 андроид ом работает,

пт, 20 дек. 2019 г., 15:14 vvip-68 <notifications@github.com>:

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

ermiyaev, 2019-12-20:
Думаю, что в эти дебри с тонкостями Kirin никто не полезет. Если только писать в поддержку Thunkable.

Есть вариант поставить модифицированную прошивку от lakec с управлением через веб морду. Из хрома на телефоне создать ярлык на рабочий стол на адрес лампы и пользовать вместо приложения. Кроме рассвета....
Для настройки рассвета можно на комп поставить NOX (эмулятор андроид), а туда поставить приложение попробовать.
Да, я знаю, что это не то, что ты спрашивал, но это какой-то выход из ситуации.

Militar49, 2019-12-20:
Спосибо

пт, 20 дек. 2019 г., 15:48 ermiyaev <notifications@github.com>:

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

Closed 2019-12-20.

Thread 17 (2020-01-04):

Ошибка компиляции под ESP32

HeKuToCbI4, 2020-01-04:
Проблема всё ещё есть при линковке библиотек. Выключение includ'а библиотеки помогает исправить ошибку.

vvip-68, 2020-01-06:
Если всё делать по инструкции, для правильно выбранной платы, с актуальными версиями ядра и библиотек - никаких проблем с компиляцией и сборкой не обнаруживается.

Closed 2020-01-06.

Thread 18 (2020-01-06):

Проблема с включением будильника из программы на андроид.

AnatolyDem, 2020-01-06:
Здравствуйте. Собрал я лампу по вашему проекту, все работает кроме будильника. Если я ставлю будильник из программы WiFiLamp на смартфоне (андроид 8.1.0) то не могу включить, если разница между реальным временем и заданным больше 10 минут.. Если разница-  например: у меня время показывает 4-05...я ставлю будильник на 4-15 или меньше...то включается (на смарте появляется кнопка отключение) будильник работает и все срабатывает. если больше 10 минут  разница, то включения нет и при нажатии в программе, в закладке "Настройки будильника", кнопки "Установить" происходит моргание лампы и ничего не меняется. Я уж и не знаю где рыть. Даже подключается программа GyverMatrix, многие режимы из нее работают, но с будильником проблема

vvip-68, 2020-01-06:
Проверил неоднократно, попросил проверить знакомых, которые собрали лампу. Никаких проблем с установкой будильника не выявлено. У всех все устанавливается и срабатывает в установленное время.
Если у вас продолжительность рассвета установлено 10 минут, то установка времени меньше чем за 10 минут до приводит сразу же к срабатыванию будильника. ТО есть - все работает правильно.
Моргание ламы - симптом странный. Не вижу причин что бы могло вызвать моргание.
Программы GyverMatrix и GyverLamp имеют похожий, но все же разный протокол обмена с устройством. Если пытаться управлять программой для несоответствующего устройства - работать корректно не будет.

AnatolyDem, 2020-01-06:
сегодня еще поэкспериментировал, почему-то все завязано со временем рассвета, как я понял можно выставить от 1 до 59 минут...вот в пределах этого времени я могу выставить будильник от реального времени. Например: если сейчас время 14-00...я ставлю рассвет 59 минут( то есть это время рассвета до сработки будильника) то могу выставить будильник не более 14-59, до этого времени будильник выставляется и срабатывает....если ставлю 15-00, то не могу включить...при начатии кнопки "Установить" лампа моргает и все, остается включенным обычный режим ...что я не так делаю...есть еще настройки которые надо изменить или выставить в прошивке...потому что первая проблема была в размерах матрицы..в прошивке была выставлена 17 на 9...а у меня 16 на 16(стандартная панель с китая) и я не мог понять почему нормально не работает

vvip-68, 2020-01-06:
А что вы ожидаете после нажатия кнопки "Установить"?

AnatolyDem, 2020-01-06:
хоть какого-то сообщения, понимания, индикатора, что будильник выставился и включился. Я конечно сейчас еще раз поставлю на часа два и посмотрю сработку будильника... и время рассвета выставлю минут 10. Может я чего не понял в логике работы и меня смущает что нет индикации что будильник включился...сейчас настрои и подожду

vvip-68, 2020-01-06:
Нет никакой индикации (на лампе). Если будильник установился - это показывается в программе, что время установлено и движок вкл/выкл в положении вкл. Время рассвета - за сколько до установленного времени будильники она включится если была выключена или переключится в режим рассвета, если был какой другой эффект. В течение указанных 10 минут будет плавно нарастать яркость. Если подключены звуки - будет воспроизводиться мелодия рассвета с плавным нарастанием громкости. Во время установленное для будильника лампа загорится ярким белым светом и включится звук будильника. Это будет происходить установленное время (обычно 1 минуту) После этого будильник выключится. Всё. Никакой жругой логики не предусмотрено.

AnatolyDem, 2020-01-06:
вот сейчас попробовал опять, у меня время 15-20, я выставил рассвет 10 минут и время сработки будильника на 16-30..нажимаю на "Установить" и лампа кратко моргает и продолжает работать...а вроде должна перейти в режим пониженной яркости и режим будильника

vvip-68, 2020-01-06:
Не должна.

AnatolyDem, 2020-01-06:
не должна "..должна перейти в режим пониженной яркости и режим будильника" Почему?...я же вроде хочу включить будильник и основной режим уже не нужен...то есть я включил будильник и теперь все работает и когда лампа не нужна отключаю ее кнопкой или со смарта и будильник работает...должен сработать...подожду

AnatolyDem, 2020-01-06:
не понятно, включился ли режим будильника..нет никакой индикации

vvip-68, 2020-01-06:
Индикация только в программе. Настраиваете нужные дни и время. Если настройки сохранены - они так и останутся как вы установили. Если что-то пошло не так - отобразится актуальное состояние настроек будильника. Установка времени срабатывания будильника вовсе не означает что оно должно перейти в режим пониженной яркости и все такое.
Я поставил время (на завтра / на послезавтра / на 5 дней вперед, а лампа продолжает работать - зачем ей переходить в режим пониженной яркости?
Если вам привычнее другая логика - исходники открыты, переделайте как нужно вам.

AnatolyDem, 2020-01-06:
спасибо, все нормально. я к сожалению не смогу настроить логику работы сам...пока учусь, помаленьку разбираюсь. Сейчас выставил время, жду сработки. Спасибо за ответы.

AnatolyDem, 2020-01-06:
все сработало нормально :) БЛАГОДАРЮ.  Буду пробовать добавить мелодии будильника. Есть какие нибудь ограничения для этого?

vvip-68, 2020-01-06:
Да не вижу пока ограничений навскидку. Кинуть в папку мало, нужно в скрипте список названий дополнить.

AnatolyDem, 2020-01-06:
да я так и понял, сейчас ищу где в скрипте прописан список...вроде видел, но пока не нашел :)

AnatolyDem, 2020-01-07:
извините :( не могу найти где прописаны звуковые файлы

vvip-68, 2020-01-07:
В основном файле проекта
#define ALARM_SOUND_LIST F("One Step Over,In the Death Car")            // Список звука для комбобокса "Звук будильника" в приложении на смартфоне
#define DAWN_SOUND_LIST F("Птицы,Гроза,Прибой,Дождь,Ручей,Мантра")      // Список звука для комбобокса "Звук рассвета" в приложении на смартфоне

AnatolyDem, 2020-01-07:
фуф...это же проект GyverLampWiFi , а не GyverMatrixOS.......в проекте GyverLampWiFi нет таких строк ...они есть в GyverMatrixOS

AnatolyDem, 2020-01-07:
в проекте GyverLampWiFi есть часы на индикаторе TM1637 и есть звуковой модуль, а в проекте GyverMatrixOS физически часов нет

vvip-68, 2020-01-07:
Эти настройки есть и там и там.
В проекте GyverMatrixOS физических часов нет.
И что?

AnatolyDem, 2020-01-07:
да я просто собирал GyverLamp из за часов с индикатором....а в проекте GyverLamp я не нашел таких или подобных строк...не нашел перечислений аудио файлов....а разве в проект GyverMatrixOS можно подключить индикатор, без правки самого проекта

vvip-68, 2020-01-07:
Естественно нельзя. Это разные проекты с разным кодом. Но код процентов на 50% совпадает. В части будильников / звуков - на все 90% совпадает. В том числе и со списками названий звуков. В этом отношении всё одинаково.

vvip-68, 2020-01-07:
Не нашел - сочувствую. Плохо искал.

AnatolyDem, 2020-01-07:
наверно плохо, но уже по 4 разу весь построчно гляжу :(

vvip-68, 2020-01-07:
В IDE есть кнопка - F3
Можно ввести строку для поиска и найти.
Ищи "ALARM_SOUND_LIST" остальное рядом
А вообще - это строки 222 и 223

AnatolyDem, 2020-01-07:
нету на этих строках таких записей....223 вообще пустая и рядом нет, искал, может сместились....я не правил, просто скачал от сюда, исправил размеры матрицы на 16/16  и все ...:(

AnatolyDem, 2020-01-07:
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

AnatolyDem, 2020-01-07:
скачивал прям здесь
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

AnatolyDem, 2020-01-07:
и строку ALARM_SOUND_LIST не находит.....я сразу начал так искать...потом сам, руками, построчно

vvip-68, 2020-01-07:
Ну тогда ничем помочь не смогу, видимо...
Вот что прямо там при открытии файла на GitHub
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

AnatolyDem, 2020-01-07:
странно. как так то....прям на сайте открывается по другому...это что, скачивается другой файл что ли?

vvip-68, 2020-01-07:
Попробуй скачать еще раз

AnatolyDem, 2020-01-07:
этот файл открытый в Arduino отсутствует кусок проекта....файл качал уже (4) четыре раза в разные папки и из каждую открывал, смотрел...сейчас еще раз скачаю

AnatolyDem, 2020-01-07:
все, в этом файле есть такие строки :)...вы исправили? обновили файл? Благодарю.

AnatolyDem, 2020-01-07:
я уже хотел этот недостающий кусок  воткнуть в ту версию с которой я мучился ;)...спасибо что исправили

vvip-68, 2020-01-07:
Ты же видишь - что последнее обновление  - 13 дней назад. И оно касалось не этого куска кода. Этот - со списком файлов - мне кажется с месяц назад был изменен... Ну или по крайней мере в начале 20-х чисел декабря...

vvip-68, 2020-01-07:
И имей в виду, что программу на телефоне требуется тоже обновить в соответствии с изменениями в прошивке.

AnatolyDem, 2020-01-07:
у меня эти файлы были скачены в разные папки, изучал мучился,  2 декабря 2019, 2 января и 6 января 2020...у всех отсутствует этот кусок

vvip-68, 2020-01-07:
Да, посмотрел по коду - он был добавлен 7 декабря

AnatolyDem, 2020-01-07:
наверно...надо поудалять лишнее скаченное, чтоб не мешало...да, от 6 января есть изменения

AnatolyDem, 2020-01-07:
Спасибо.

AnatolyDem, 2020-01-07:
все отлично добавилось, прописалось. Музыка играет, лампа радует. Благодарю за помощь.

Closed 2020-01-06.

Thread 20 (2020-03-14):

Окно поиска локальной сети не открывается после подключения к точке доступа

ACKET2009, 2020-03-14:
Здравствуйте! Не могу получить окно поиска и подключения к локальной сети. Подключился к точке доступа и всё на этом... зайти на 4.1 не даёт... как настраивать, не понятно.. приложение на хуавей мейт 20 не запустилось, хотя от Алекса и Ганнера приложения работают. Хотел именно Ваш вариант запустить. с сенсорной кнопкой нашёл где настройки поменять, с неё управляется, а с сетью засада какая-то... Указал напрямую точку доступа  и пароль, потом поменял явно указанный 192.168.0.116 на 1.116 (в своей сети, тогда прицепилась) Но с телефона не получилось так чтобы настроить и сохранить в епром. прошивал с перезаписью всего...

Zluka-MV, 2020-04-02:
Поддерживаю, у меня проблема с приложением на Huawei Nova 2i. Лампа работает только в деморежиме, к роутеру подключилась, время показывает. Приложение не запускается, просто белый экран и потом сбрасывается. На виртуальном андроиде приложение запустилось. но не соеденилось.

vvip-68, 2020-04-16:
Данный вариант не использует WiFiManager (всё делается прямым указанием адреса подключения) - следовательно никакого окна поиска локальной сети и быть не может. Это вы с каким-то другим проектом попутали. С тем, что вместо приложения белый экран - не подскажу, не сталкивался. Возможно ваша версия андроида не поддерживается приложением или несовместимость с какими-то другими установленными приложениями

Closed 2020-04-16.

Thread 21 (2020-04-11):

Не создает Wi-fi сеть

Neo20201, 2020-04-11:
Здравствуйте. После прошивки лампа запускается,но в поиске Wi-fi только есть AppLamp и все, AutoConnectAP отсутствует . В строке 366 указал имя NETWORK_SSID "AutoConnectAP" в строке 367 указал пароль   NETWORK_PASS "12345678"   В eeprom менял флаг как написано в разделе FAQ. Так же в 536 строке стоит WiFi.mode(WIFI_STA),Но лампа работает только в режиме точки доступа, а сеть для подключения ее к роутеру не создает  ПРОШУ ПОМОГИТЕ ПОЖАЙЛУСТА РЕШИТЬ ВОПРОС!!!!!

vvip-68, 2020-04-16:
Это всё, что вы описали - из какого-то другого проекта. Данный проект ничего такого не поддерживает, и название точки доступа другое, и пароль для подключения другой. Как подключиться и что указывать - всё на главной страничке проекта написано.

Neo20201, 2020-04-17:
Все же я сумел разобраться. После подключения к точке доступа все настройки есть в самой программе для мобильного устройства.

Closed 2020-04-16.

Thread 22 (2020-10-08):

Ошибки компиляции при активации проигрывателя mp3 и TM1627

Geonm778, 2020-10-08:
Не могу скомпилировать при активации проигрывателя mp3 и TM1627 (версия 1.05). Выдается много ошибок. Проект больше не предполагает работу с лампой 16х16, mp3 проигрывателем и дисплеем? Просто схема с ними в проекте присутствует. При этом без mp3 и ТМ1627 компиляция проходит.

Closed 2020-10-08.

Thread 23 (2020-12-16):

Ошибка

ooomakon, 2020-12-16:
Здравствуйте,выдаёт ошибку
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

vvip-68, 2020-12-16:
Полагаю, что у вас идет сборка под ESP32 и стоит старая версия ядра?
Либо обновите версию ядра до актуальной, либо определите max() дефайном

#if defined(ESP32)
#ifndef min
  #define min(a,b) (((a) < (b)) ? (a) : (b))
#endif
#ifndef max
  #define max(a,b) (((a) > (b)) ? (a) : (b))
#endif
#endif

vvip-68, 2020-12-16:
Либо это порожденная (вторичная) ошибка, и настоящая ошибка-первопричины - выше по логу компиляции

ooomakon, 2020-12-16:
еслиб я понимал ,то было бы хорошо

vvip-68, 2020-12-16:
Ну, ок. А от меня то вы что хотите? Я чем могу помочь?
Зайти удаленно на ваш комп, все проверить, настроить, устранить ошибку и собрать всё?

vvip-68, 2020-12-16:
Судя по скриншоту  и проекту (я повспоминал) - это не связано с ESP32 и версией - это ошибка порожденная и нужно в логе компиляции смотреть первопричину

ooomakon, 2020-12-16:
Всё удалил и на чистое поставил Ардуино,прошилось и заработало!Спасибо!

Closed 2020-12-16.

Thread 24 (2022-03-08):

Unable to control Lamp

DrSaad77, 2022-03-08:
Здравствуйте, спасибо за добавление часов и динамиков в GyverLamp.
Я не могу управлять лампой??
Загрузил скетч на esp8622, лампа работает.
Лампа появляется в сети Wi-Fi на моем телефоне как LampAP, и я могу подключиться к ней с паролем 12341234.
Но после этого я не могу управлять лампой.
Я пробую Chrome, IP: 192.168.4.1, как указано на главной странице проекта, но это не работает.
Я также попробовал IP: 192.168.4.2, потому что в сети Wi-Fi это IP-адрес esp8622/LampAP, но он не работает.
Я также пробую все виды IP-адресов в приложении для Android и все еще не могу управлять лампой.
Мне нужно добавить имя моей сети Wi-Fi и ее пароль в строке 366 и 367.
а может в строке 373 и 374??
Я действительно не знаю, что еще попробовать.
Спасибо, если вы можете, пожалуйста, скажите мне, что я должен сделать, чтобы иметь возможность управлять лампой.
Спасибо вам.

vvip-68, 2022-03-09:
А при чем тут Chrome? На странице проекта нигде не написано, что эта прошивка принимает управление через Web-браузер. Это не поддерживается. Управление только из специального приложения, которое лежит в папке Android проекта.

При управлении лампой из приложения - подключите свой телефон к сети "LampAP", затем в приложении в адресе соединения укажите 192.168.4.1, значение порта менять не нужно . Далее нажмите кнопку "Соединиться".

Штатно подразумевается, что имя сети и пароль подключения настраиваются в приложении при подключении через точку доступа. В скетче имя сети и пароль доступа можно указать в строках 366 и 367. Желаемый IP адрес, который лампа должна получить при подключении к сети - в строке 378. Обратите внимание, чтобы указанный адрес находился в диапазоне адресов вашего роутера, иначе лампа окажется фактически в другой сети и управлять ей будет невозможно.

Подключилась ли лампа к сети и какой адрес использует (или произошло создание собственной точки доступа) - видно в логе в мониторе порта при запуске лампы.

DrSaad77, 2022-03-09:
Добрый вечер! Большое спасибо, что нашли время ответить мне.
Вы правы насчет навигатора Chrome, я был неправ в этом. просто у меня больше не было идей попробовать.

ваше Android-приложение безумно красивое, полное приятных функций. Будем надеяться, что когда-нибудь он получит обновление, конечно, только вам решать об этом.
В настоящее время я пробую все доступные версии GyverLamp, и ваша потрясающая!

Еще раз большое спасибо за все пояснения и за потраченное время ))
