vvip-68/GyverLampWiFi/firmware/GyverLampWiFi_v1.02/utility.ino

// служебные функции

// шрифт 5х7
const uint8_t font5x7[][5] PROGMEM = {
  {0x3e, 0x51, 0x49, 0x45, 0x3e}, // 0 0x30 48
  {0x00, 0x42, 0x7f, 0x40, 0x00}, // 1 0x31 49
  {0x42, 0x61, 0x51, 0x49, 0x46}, // 2 0x32 50
  {0x21, 0x41, 0x45, 0x4b, 0x31}, // 3 0x33 51
  {0x18, 0x14, 0x12, 0x7f, 0x10}, // 4 0x34 52
  {0x27, 0x45, 0x45, 0x45, 0x39}, // 5 0x35 53
  {0x3c, 0x4a, 0x49, 0x49, 0x30}, // 6 0x36 54
  {0x01, 0x71, 0x09, 0x05, 0x03}, // 7 0x37 55
  {0x36, 0x49, 0x49, 0x49, 0x36}, // 8 0x38 56
  {0x06, 0x49, 0x49, 0x29, 0x1e}, // 9 0x39 57
};

// шрифт 3х5 квадратный
const uint8_t font3x5[][3] PROGMEM = {
  {0b11111, 0b10001, 0b11111},    // 0
  {0b00000, 0b11111, 0b00000},    // 1
  {0b10111, 0b10101, 0b11101},    // 2
  {0b10101, 0b10101, 0b11111},    // 3
  {0b11100, 0b00100, 0b11111},    // 4
  {0b11101, 0b10101, 0b10111},    // 5
  {0b11111, 0b10101, 0b10111},    // 6
  {0b10000, 0b10000, 0b11111},    // 7
  {0b11111, 0b10101, 0b11111},    // 8
  {0b11101, 0b10101, 0b11111},    // 9
};

// шрифт 3х5 скруглённый
const uint8_t font3x5_s[][3] PROGMEM = {
  {0b01111, 0b10001, 0b11110},    // 0
  {0b01000, 0b11111, 0b00000},    // 1
  {0b10011, 0b10101, 0b01001},    // 2
  {0b10001, 0b10101, 0b11111},    // 3
  {0b11100, 0b00100, 0b11111},    // 4
  {0b11101, 0b10101, 0b10111},    // 5
  {0b01111, 0b10101, 0b10111},    // 6
  {0b10000, 0b10011, 0b11100},    // 7
  {0b11111, 0b10101, 0b11111},    // 8
  {0b11101, 0b10101, 0b11110},    // 9
};

// нарисовать цифру шрифт 3х5 квадратный
void drawDigit3x5(byte digit, int8_t X, int8_t Y, CRGB color) {
  if (digit > 9) return;
  for (byte x = 0; x < 3; x++) {
    byte thisByte = pgm_read_byte(&(font3x5[digit][x]));
    for (byte y = 0; y < 5; y++) {
      if (y + Y > HEIGHT) continue;
      if (thisByte & (1 << y)) drawPixelXY(getClockX(x + X), y + Y, color);
    }
  }
}

// нарисовать цифру шрифт 3х5 скруглённый
void drawDigit3x5_s(byte digit, int8_t X, int8_t Y, CRGB color) {
  if (digit > 9) return;
  for (byte x = 0; x < 3; x++) {
    byte thisByte = pgm_read_byte(&(font3x5_s[digit][x]));
    for (byte y = 0; y < 5; y++) {
      if (y + Y > HEIGHT) continue;
      if (thisByte & (1 << y)) drawPixelXY(getClockX(x + X), y + Y, color);
    }
  }
}

// нарисовать цифру шрифт 5х7
void drawDigit5x7(byte digit, byte X, byte Y, CRGB color) {
  if (digit > 9) return;
  for (byte x = 0; x < 5; x++) {
    byte thisByte = pgm_read_byte(&(font5x7[digit][x]));
    for (byte y = 0; y < 7; y++) {
      if (x + X > WIDTH || y + Y > HEIGHT) continue;
      if (thisByte & (1 << 6 - y)) drawPixelXY(x + X, y + Y, color);
    }
  }
}
// залить все
void fillAll(CRGB color) {
  for (int i = 0; i < NUM_LEDS; i++) {
    leds[i] = color;
  }
}

// функция отрисовки точки по координатам X Y
void drawPixelXY(int8_t x, int8_t y, CRGB color) {
  if (x < 0 || x > WIDTH - 1 || y < 0 || y > HEIGHT - 1) return;
  int thisPixel = getPixelNumber(x, y) * SEGMENTS;
  for (byte i = 0; i < SEGMENTS; i++) {
    leds[thisPixel + i] = color;
  }
}

// функция получения цвета пикселя по его номеру
uint32_t getPixColor(int thisSegm) {
  int thisPixel = thisSegm * SEGMENTS;
  if (thisPixel < 0 || thisPixel > NUM_LEDS - 1) return 0;
  return (((uint32_t)leds[thisPixel].r << 16) | ((long)leds[thisPixel].g << 8 ) | (long)leds[thisPixel].b);
}

// функция получения цвета пикселя в матрице по его координатам
uint32_t getPixColorXY(int8_t x, int8_t y) {
  return getPixColor(getPixelNumber(x, y));
}

// **************** НАСТРОЙКА МАТРИЦЫ ****************
#if (CONNECTION_ANGLE == 0 && STRIP_DIRECTION == 0)
#define _WIDTH WIDTH
#define THIS_X x
#define THIS_Y y

#elif (CONNECTION_ANGLE == 0 && STRIP_DIRECTION == 1)
#define _WIDTH HEIGHT
#define THIS_X y
#define THIS_Y x

#elif (CONNECTION_ANGLE == 1 && STRIP_DIRECTION == 0)
#define _WIDTH WIDTH
#define THIS_X x
#define THIS_Y (HEIGHT - y - 1)

#elif (CONNECTION_ANGLE == 1 && STRIP_DIRECTION == 3)
#define _WIDTH HEIGHT
#define THIS_X (HEIGHT - y - 1)
#define THIS_Y x

#elif (CONNECTION_ANGLE == 2 && STRIP_DIRECTION == 2)
#define _WIDTH WIDTH
#define THIS_X (WIDTH - x - 1)
#define THIS_Y (HEIGHT - y - 1)

#elif (CONNECTION_ANGLE == 2 && STRIP_DIRECTION == 3)
#define _WIDTH HEIGHT
#define THIS_X (HEIGHT - y - 1)
#define THIS_Y (WIDTH - x - 1)

#elif (CONNECTION_ANGLE == 3 && STRIP_DIRECTION == 2)
#define _WIDTH WIDTH
#define THIS_X (WIDTH - x - 1)
#define THIS_Y y

#elif (CONNECTION_ANGLE == 3 && STRIP_DIRECTION == 1)
#define _WIDTH HEIGHT
#define THIS_X y
#define THIS_Y (WIDTH - x - 1)

#else
#define _WIDTH WIDTH
#define THIS_X x
#define THIS_Y y
#pragma message "Wrong matrix parameters! Set to default"

#endif

// получить номер пикселя в ленте по координатам
uint16_t getPixelNumber(int8_t x, int8_t y) {
  if ((THIS_Y % 2 == 0) || MATRIX_TYPE) {               // если чётная строка
    return (THIS_Y * _WIDTH + THIS_X);
  } else {                                              // если нечётная строка
    return (THIS_Y * _WIDTH + _WIDTH - THIS_X - 1);
  }
}

// hex string to uint32_t
uint32_t HEXtoInt(String hexValue) {
  byte tens, ones, number1, number2, number3;
  tens = (hexValue[0] < '9') ? hexValue[0] - '0' : hexValue[0] - '7';
  ones = (hexValue[1] < '9') ? hexValue[1] - '0' : hexValue[1] - '7';
  number1 = (16 * tens) + ones;

  tens = (hexValue[2] < '9') ? hexValue[2] - '0' : hexValue[2] - '7';
  ones = (hexValue[3] < '9') ? hexValue[3] - '0' : hexValue[3] - '7';
  number2 = (16 * tens) + ones;

  tens = (hexValue[4] < '9') ? hexValue[4] - '0' : hexValue[4] - '7';
  ones = (hexValue[5] < '9') ? hexValue[5] - '0' : hexValue[5] - '7';
  number3 = (16 * tens) + ones;

  return ((uint32_t)number1 << 16 | (uint32_t)number2 << 8 | number3 << 0);
}

uint32_t CountTokens(String str, char separator) {

  uint32_t count = 0;
  int pos = 0;
  String l_str = str;

  l_str.trim();
  if (l_str.length() <= 0) return 0;
  pos = l_str.indexOf(separator);
  while (pos >= 0) {
    count++;
    pos = l_str.indexOf(separator, pos + 1);
  }
  return ++count;
}

String GetToken(String str, uint32_t index, char separator) {

  uint32_t count = CountTokens(str, separator);

  if (count <= 1 || index < 1 || index > count) return str;

  uint32_t pos_start = 0;
  uint32_t pos_end = str.length();

  count = 0;
  for (uint32_t i = 0; i < pos_end; i++) {
    if (str.charAt(i) == separator) {
      count++;
      if (count == index) {
        pos_end = i;
        break;
      } else {
        pos_start = i + 1;
      }
    }
  }
  return str.substring(pos_start, pos_end);
}

uint32_t getColorInt(CRGB color) {
  return color.r << 16 | color.g << 8 | color.b;
}
