vvip-68/GyverLampWiFi/(commit log)

2019-07-05 Начальная загрузка проекта
    [Lamp-Top.stl, Lamp_Down.stl, Lamp_Down_DC-output.stl, Ring_top.stl, ring_for_paper.stl]
2019-07-05 Определение IP адреса сервера времени вынесено из процедуры запроса точного времени в setup() и на событие установки нового имени сервера NTP
2019-07-06 Принудительное (контрольное) отключение звука будильника после останова. MP3 DFPlayer не всегда реагирует на команду stop() и продолжает воспроизводить звук. После того как заук будильника остановлен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
2019-07-10 Изменения в логике включения и отображения времени При выключенной лампе: - если время не получено с NTP индикатор отображает --:-- даже если в настройках значится "при выключении лампы выключать инд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
2019-07-10 Увеличен таймаут ожидания ответа NTP сервера
2019-07-10 Проверка устанавливаемого IP адреса на принадлежность к локальной сети (10.x.x.x или 172.16.x.x .. 172.31.x.x или 192.168.x.x) Если адрес не принадлежит локальной сети - статический адрес сбрасываетс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
2019-07-10 Исправлено: условие проверки необходимости отключения звука, если не рассвет, не будильник и не проигрывание примеров
2019-08-30 Мелкие изменения, накопившиеся со временем
2019-08-30 В приложении на смартфоне улучшен алгоритм проверки наличия/потери соединения с лампой
2019-09-01 Добавлено определение USE_MP3 для версий без MP3 плеера
2019-09-01 Исправлено: k0cm0 => продолжает работать в режиме AP_STA после получения статического адреса
2019-09-02 idleTime=0 отключает автовозврат в демо-режим (не сохранялось)
2019-09-03 Имя/пароль сети - инициализация дефолтными значениями для того чтобы при первой прошивке подхватывались сразу, а не после перезагрузки
2019-09-04 EEPROM - адрес как uint_16
2019-09-04 Схема подключения с физической кнопкой
2019-09-04 Вариант с обычной кнопкой вместо сенсорной
2019-09-04 Сохранение состояния лампы (Выключено/Любимый режим/Демо-режимы). При случайной перезагрузке лампы она восстановится в режим, предшествовавший "падению".
2019-09-04 Исправлено - если в качестве эффекта рассвета выбирался эффект кроме "Рассвет" - при срабатывании рассвета эффект не отображался
    [custom.ino, effects.ino]
2019-09-05 Исправлено: После того как тип thisMode сменился с int8_t на byte в одном из предыдущих коммитов - стал неправильно работать переключение режимов назад по списку;
    [custom.ino]
2019-09-05 Исправлены подписи к пинам RX/TX на схеме
2019-09-08 Добавлены две кнопки быстрокго включения режимов Матрица и Светлячки
2019-09-11 Обновлены библиотеки GyverLibs, исправлена программа для соответствия обновленным библиотекам
    [a_main.ino]
2019-09-17 Исправлена процедура записи строки в EEPROM
    [eeprom.ino]
2019-09-18 Исправлено: не сохранялось время бездействия (IDLE)
    [eeprom.ino]
2019-09-26 Заметки для использующих Wemos D1
2019-09-27 Исправлен размер буфера под имя точки доступа / пароль к точке доступа
2019-09-27 Комментарий к изменению параметров подключения к сети
2019-10-05 комментарии
2019-10-25 Вывод в монитор порта версии прошивки при запуске
2019-11-05 Версия 1.01 - начальная выгрузка
2019-11-06 Библиотека SowtwareSerial для ESP32
2019-11-06 Update uint16_t to uint32_t in №71 str
    Update uint16_t to uint32_t in №71 str
2019-11-06 Исправлен эффект Пейнтбол для неквадратных матриц
    [clock.ino, effects.ino]
2019-11-07 Единая библиотека TM1637 для ESP32 и ESP8266
2019-11-07 Переопределение констант символов дисплея TM1637 из за их конфликта с какими-то определениями макросов в библиотеке ядра ESP8266 Очистка кода от неиспользуемых кусков
2019-11-07 Кнопка быстрого включения эффекта "Конфетти" из программы теперь включает эффект "Пейнтбол" Эффект "Пейнтбол" не имеет настроек - в приложении на смартфоне ползунок "Вариации" недоступен
2019-11-07 Fixed timing visual IP on TM1637
    При 5-ти кратном нажатии на кнопку, IP адрес показывался на TM1637 слишком быстро.
    [clock.ino]
2019-11-07 Обновление приложения для смартфона
2019-11-08 Приложение для смартфона - содержимое бокового меню при отсутствии подключения к лампе - убраны недоступные пункты
2019-11-08 Защита от попытки подключить приложение вместо лампы - к телефону, указав его собственный IP адрес
2019-11-08 Обновление версии
2019-11-08 Исправлено: вход в приложение на смартфоне сбрасывал установленный режим "Ночные часы"
    [a_main.ino, clock.ino]
2019-11-09 Исправлено: При первом запуске имя сети и пароль не инициализировались в EEPROM, что при последующих запусках приводило к попыткам подключения к несуществующей сети с непонятным именем. Спасибо Иван 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
    [eeprom.ino]
2019-11-09 Исправлен эффект Пейнтбол для квадратных матриц
    [clock.ino, effects.ino]
2019-11-10 Технический.Не рекомендовано к установке. Исправление под версию ядря ESP8266 версиии 2.6 (ранее было 2.5.2) - но сломался звук, не видит звуковую карту Исправлено - расчет будильника, не регулировал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
    [a_main.ino, clock.ino, custom.ino, effects.ino]
2019-11-11 Совместимость с версией ядра ESP8266 - 2.6.0; Возврат к библиотеке GyverTM1637; Компилируемость под ESP32
2019-11-11 Комментарий к использованию EspSoftwareSerial 5.4 или 6.0
2019-11-11 Отображение текущего IP лампы на матрице по пятикратному нажатию кнопки
2019-11-11 USE_MP3 - условная компиляция частей кода при использовании / не использовании звуковой карты
2019-11-12 Добавлен эффект "Водоворот"; Разблокирована регулировка скорости эффекта "Пкейнтбол"
2019-11-14 Исправлено: переполнение буфера команд, приводившее к зависанию Часов TM1637 при подключении программы на смартфоне к матрице
    [a_main.ino]
2019-11-15 Добавлена задержка для нормальной работы WiFi
2019-11-15 В папку libraries добавлена альтернативная библиотека управления TM1637
2019-11-15 библиотека GyverTM1637 заменана на универсальную для ESP8266 и ESP32 - TM1637Display Добавлен вариант компиляции для ядра ESP8266 версии 2.6.1 Уменьшен таймаут ожидания ответа от DFPlayer при отправк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
2019-11-18 Исправлено: быстрые кнопки в приложении, лампа выбранного цвета - выбор цвета не работал
2019-11-18 номер версии
2019-11-25 В приложение в раздел "Режимы по времени" добавлен элемент выбора "Ночные часы"
2019-11-26 В режиме "Ночные часы" ползунок яркости не регулирует япкость часов, отображаемых на матрице; Они остаются на минимально возможной яркости для заданного цвета
2019-11-26 Исправлено: неверный адрес dEEPROM для хранения настроек лимита по току (пересекался с цветом часов бегущей строки)
    [eeprom.ino]
2019-11-27 Найдена и устранена причина отваливания WiFi в режиме точке доступа.
2019-11-27 Смена версии
2019-11-30 Исправление мелких ошибок
2019-12-02 Исправлено: "дрожание" часов поверх эффектов при некоторых сочетаниях скорости эффекта и скорости сдвига часов
    [custom.ino]
2019-12-04 Испралено - кнопка "Предыдущий" переключала назад только до первого эффекта в списке
2019-12-07 Список звуков бкдильника и рассвета теперь задается в скетче и выгружается в приложение на смартфоне при соединении с лампой.
2019-12-09 Загрузка иллюстрация к инструкции "Сборка проекта"
2019-12-16 Схема преобразователя уровня 3.3В -> 5В
2019-12-17 Исправлено - часть элементов управления не вмещалась на телефоне с малым разрешением экрана
2019-12-26 Конфигурирование подключения к WiFi - добавлены параметры dns1 и dns2
2020-07-26 Обновление библиотек до актуальных версий
2020-07-29 Эффекты "Пейнтбол" и "Водоворот" исправлены для работы с неквадратными матрицами. Два режима - растягивать или повторять квадратные сегменты.
    [effects.ino]
